DumberThanUsual/EEE3-Instrumentation/stupid drawing.jpg

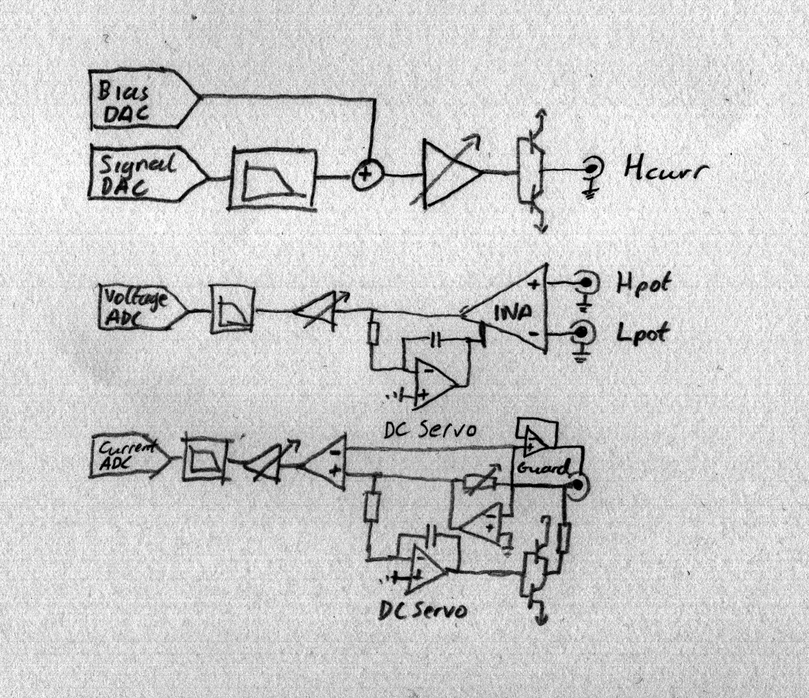
stupid drawing.jpg
