DumberThanUsual/EEE3-Instrumentation/Matlab App/Circuit Symbols/capacitor.png

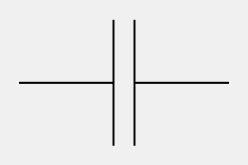
Matlab App/Circuit Symbols/capacitor.png
