DumberThanUsual/EEE3-Instrumentation/Matlab App/Circuit Symbols/impedance.png

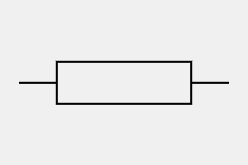
Matlab App/Circuit Symbols/impedance.png
