DumberThanUsual/EEE3-Instrumentation/Matlab App/Circuit Symbols/inductor.png

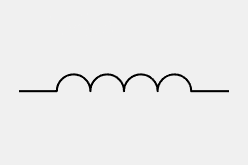
Matlab App/Circuit Symbols/inductor.png
