DumberThanUsual/EEE3-Instrumentation/Matlab App/Circuit Symbols/open.png

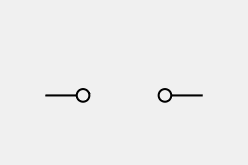
Matlab App/Circuit Symbols/open.png
