DumberThanUsual/EEE3-Instrumentation/Matlab App/Circuit Symbols/Other/base.png

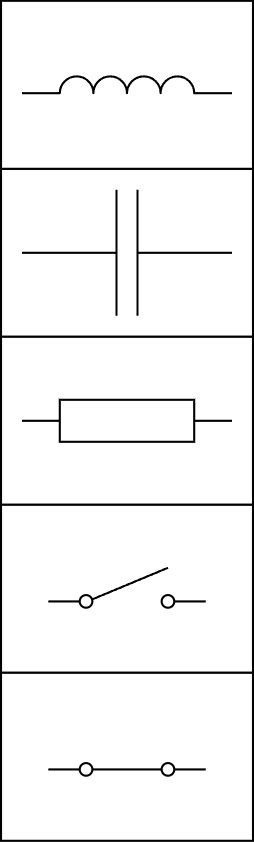
Matlab App/Circuit Symbols/Other/base.png
