DumberThanUsual/EEE3-Instrumentation/Report/Matlabs/sampleerrorvR.png

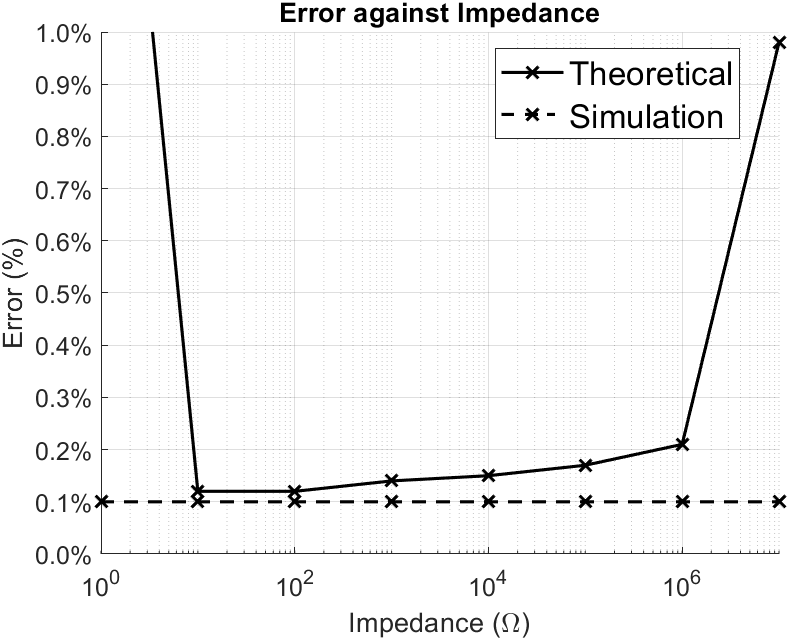
Report/Matlabs/sampleerrorvR.png
