DumberThanUsual/EEE3-Instrumentation/Report/Scopes/SIGLENT/SDS824X_HD_PNG_1.png

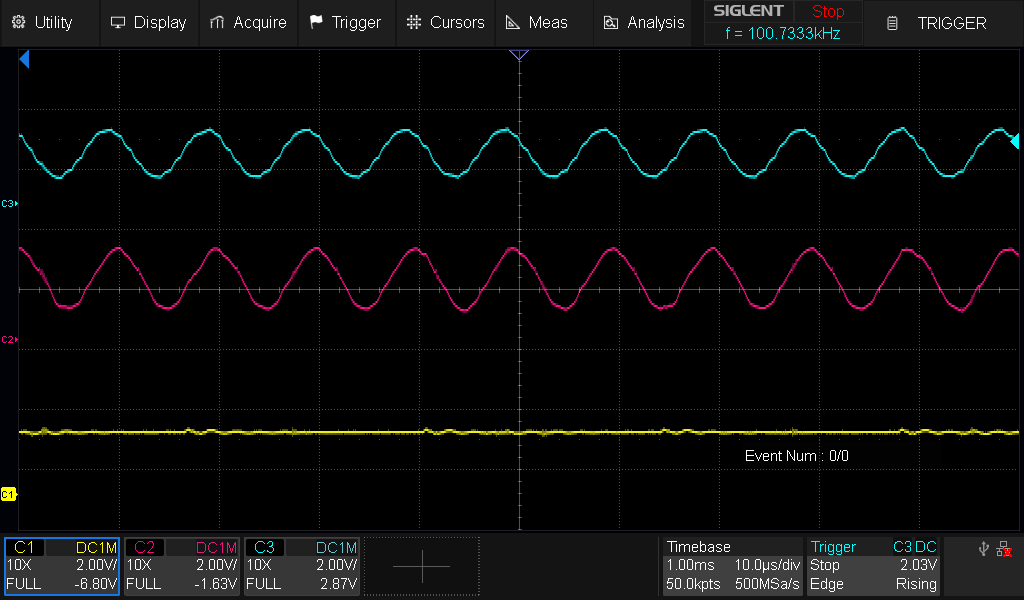
Report/Scopes/SIGLENT/SDS824X_HD_PNG_1.png
