DumberThanUsual/EEE3-Instrumentation/Report/Scopes/SIGLENT/SDS824X_HD_PNG_3.png

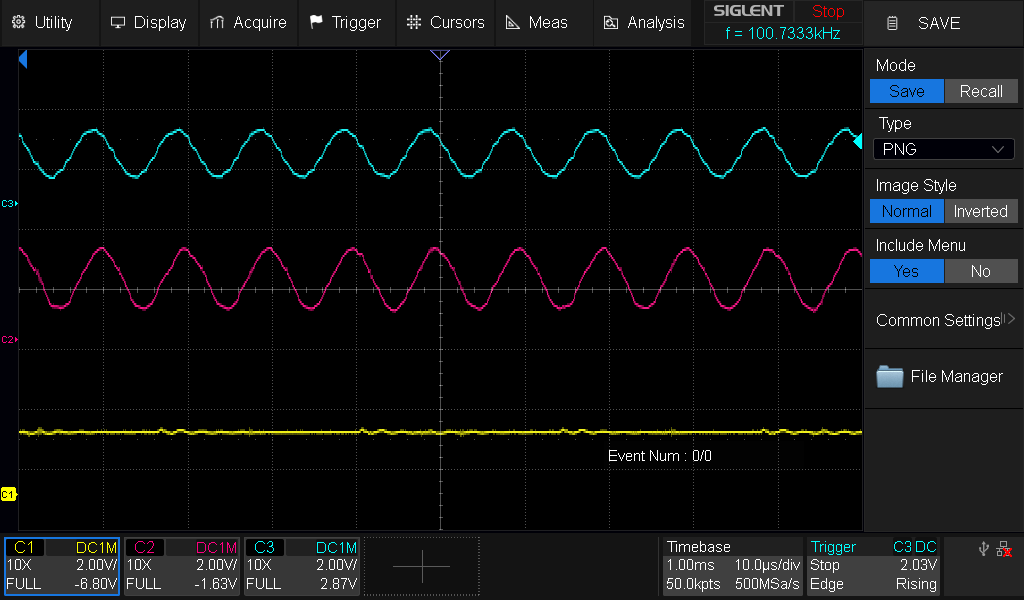
Report/Scopes/SIGLENT/SDS824X_HD_PNG_3.png
