DumberThanUsual/EEE3-Instrumentation/Report/Scopes/SIGLENT/SDS824X_HD_PNG_15.png

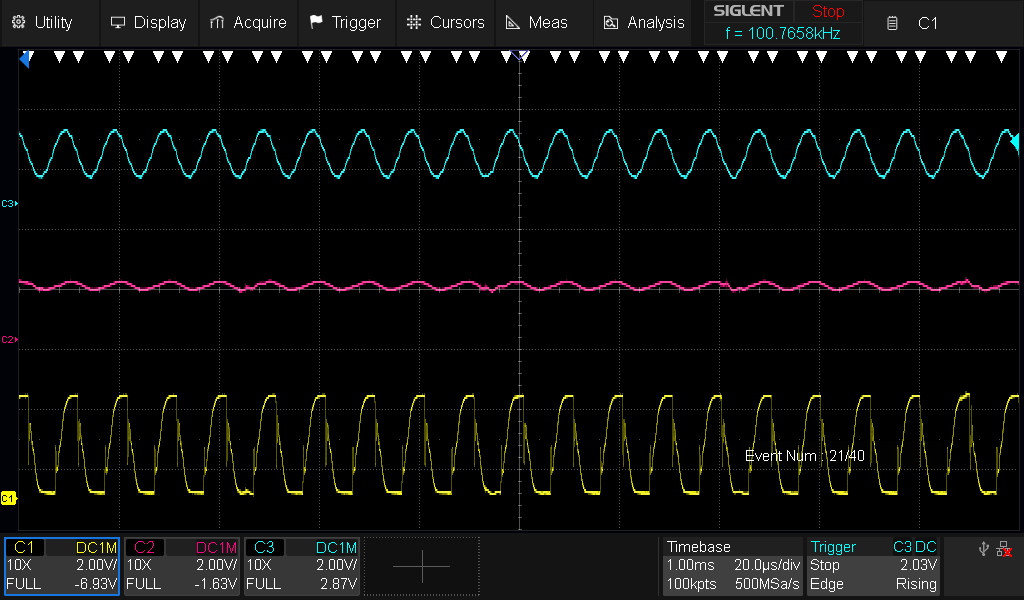
Report/Scopes/SIGLENT/SDS824X_HD_PNG_15.png
