DumberThanUsual/EEE3-Instrumentation/Report/Scopes/SIGLENT/SDS824X_HD_PNG_28.png

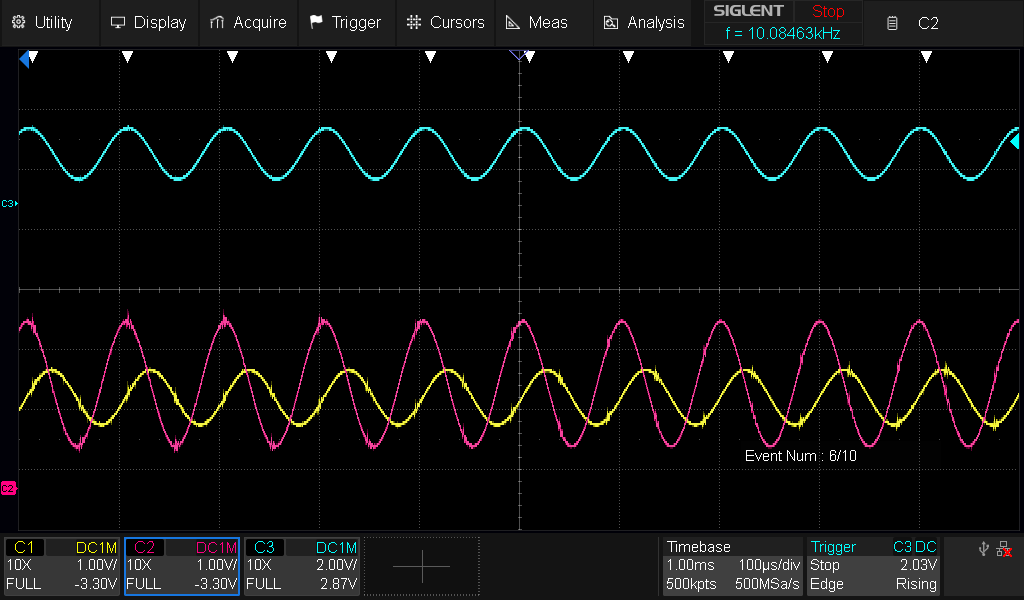
Report/Scopes/SIGLENT/SDS824X_HD_PNG_28.png
