DumberThanUsual/EEE3-Instrumentation/Report/Scopes/SIGLENT/using/SDS824X_HD_PNG_20.png

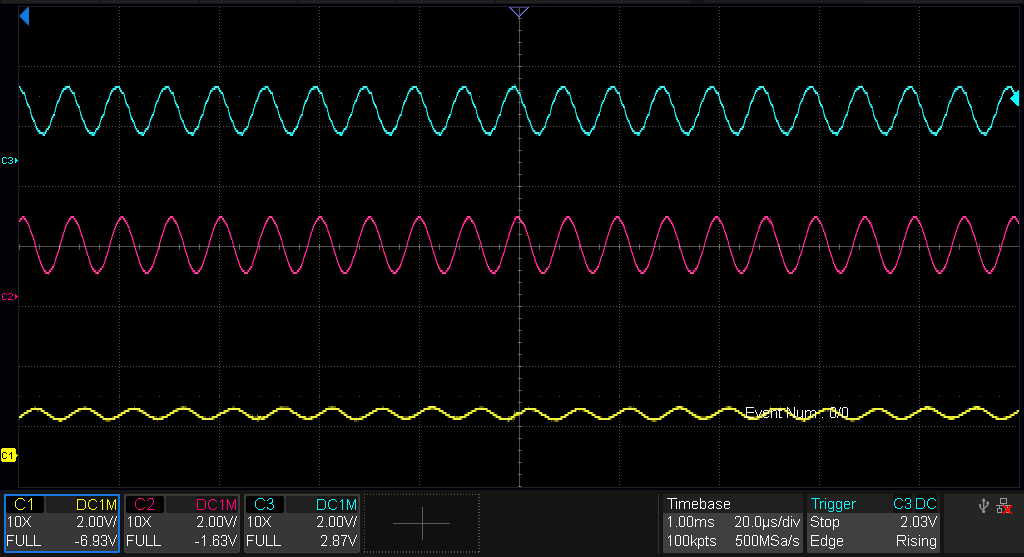
Report/Scopes/SIGLENT/using/SDS824X_HD_PNG_20.png
