DumberThanUsual/EEE3-Instrumentation/Simulations/2.2u.png

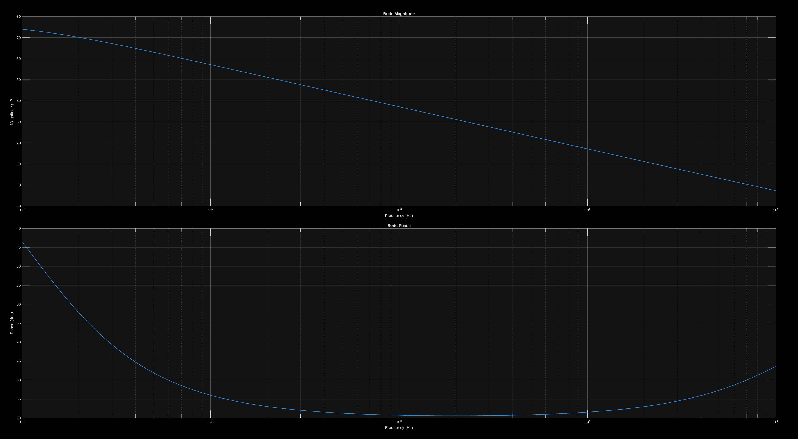
Simulations/2.2u.png
