DumberThanUsual/EEE3-Instrumentation/Simulations/Pasted image.png

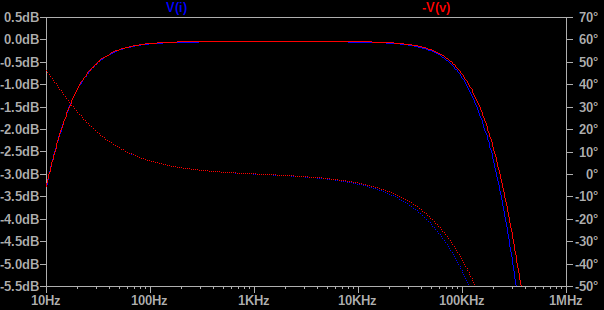
Simulations/Pasted image.png
