DumberThanUsual/EEE3-Instrumentation/Simulations/untitled.png

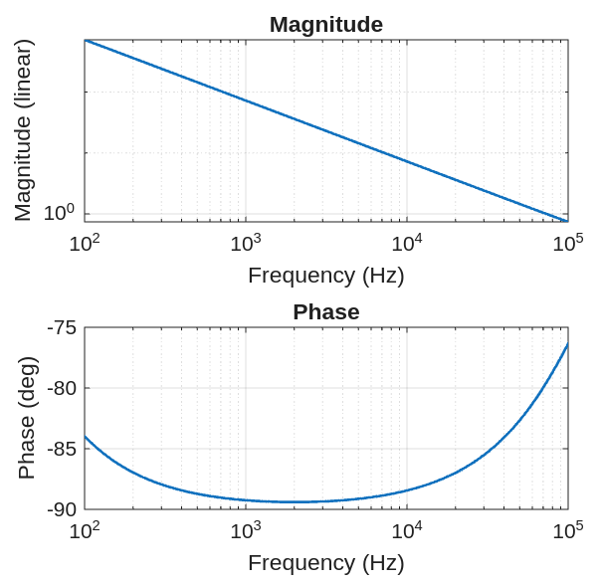
Simulations/untitled.png
