DumberThanUsual/EEE3-Instrumentation/uidiagram.bmp

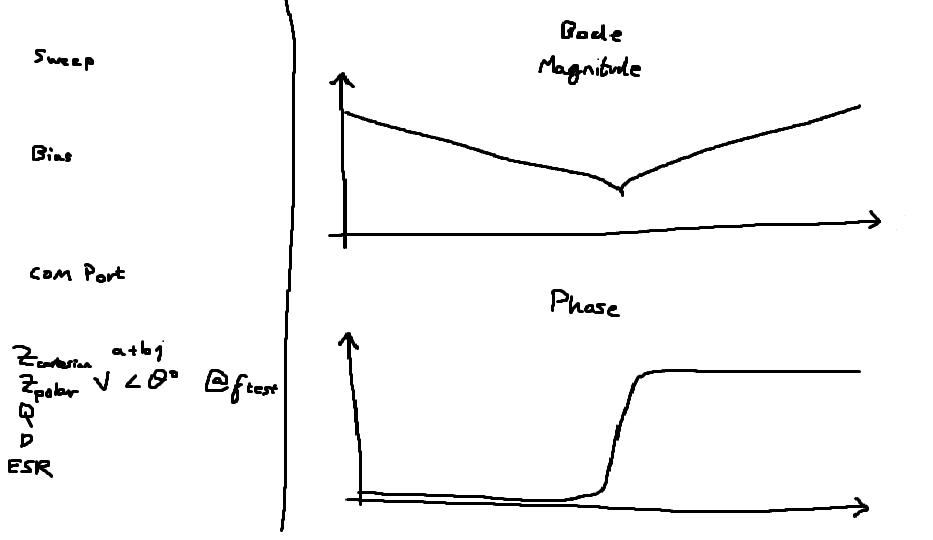
uidiagram.bmp
