DumberThanUsual/EEE3-Instrumentation/PCB/Main Board/Symbols/New folder/4816P-R2R-103LF/3D/4816P-R2R-103LF.stp

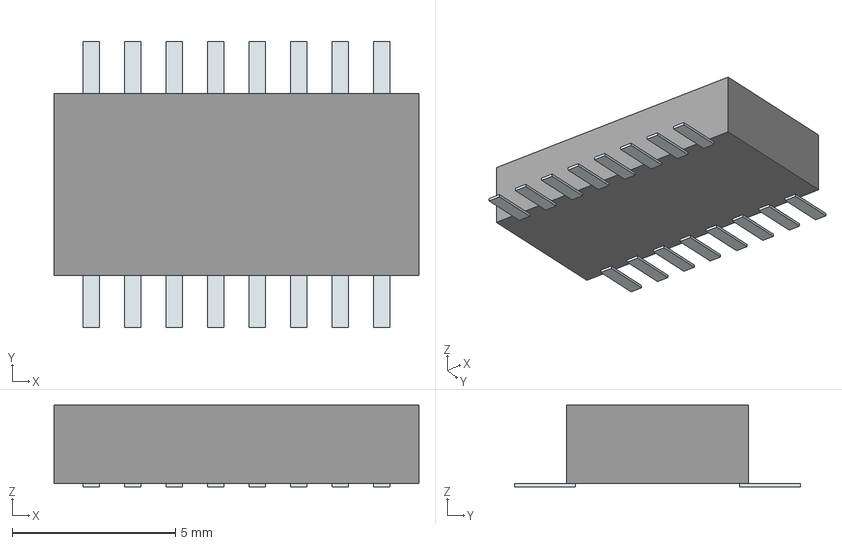
[picture p43: CAD file, 2026-03-01]
PCB/Main Board/Symbols/New folder/4816P-R2R-103LF/3D/4816P-R2R-103LF.stp
11.2 x 8.77 x 2.50 mm
Pins
