DumberThanUsual/EEE3-Instrumentation/(list of files, cad)

Other CAD files:
PCB/Main Board/Symbols/New folder/4816P-R2R-103LF/DEHDL/4816p_r2r_103lf/chips/chips.prt
