DumberThanUsual/EEE3-Instrumentation/PCB/Schematics/Main Board.pdf

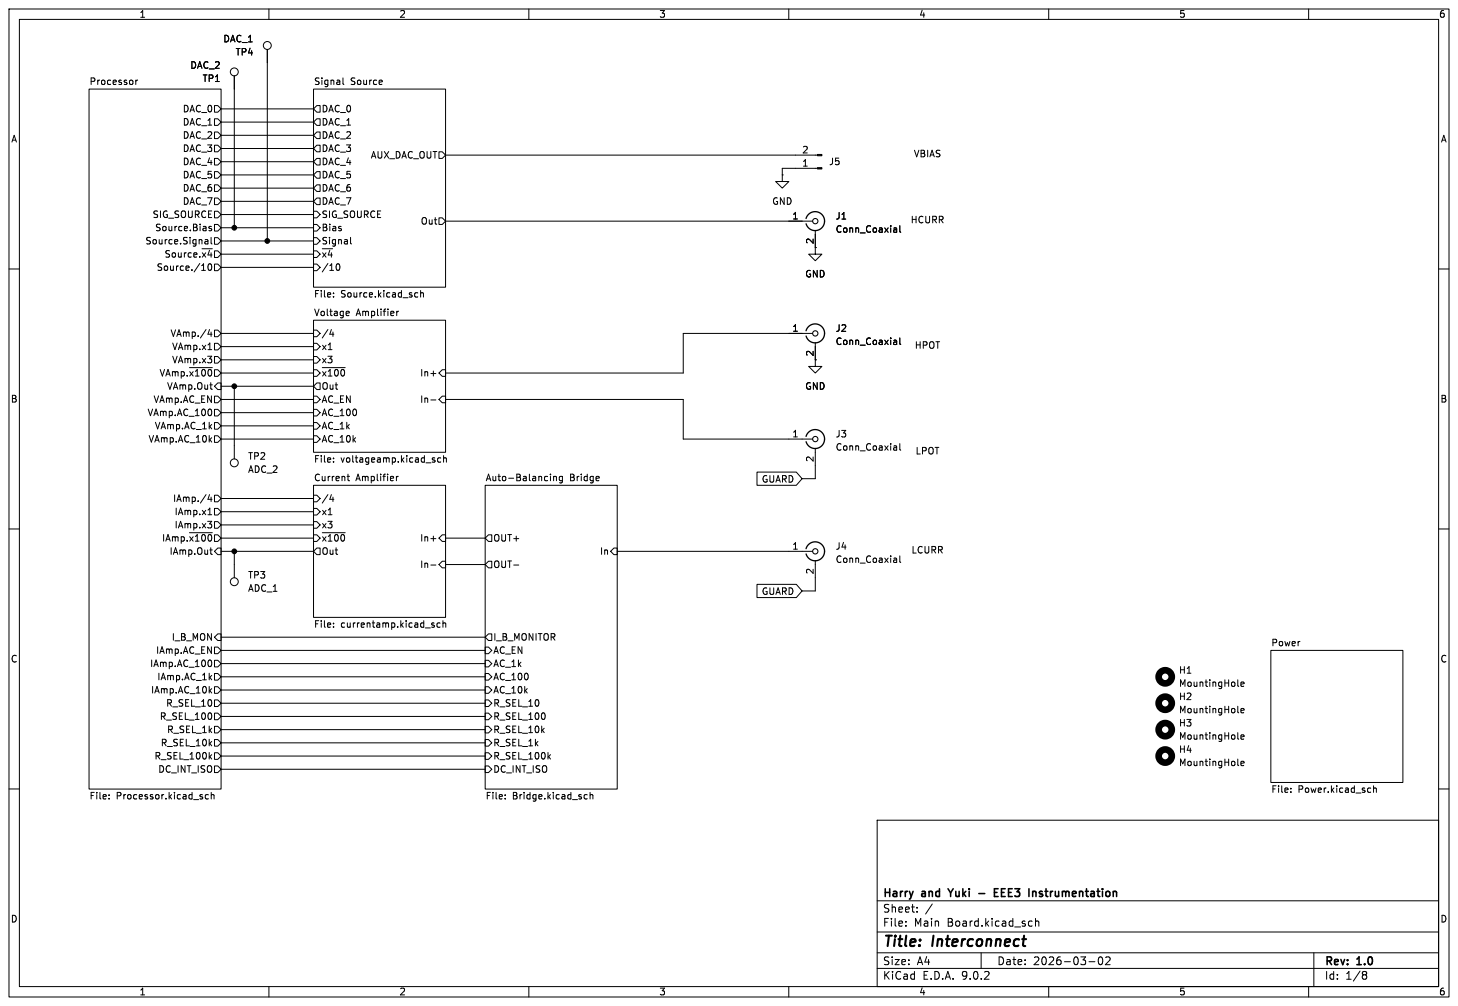
[picture p44: page 1]

IAmp.~{x100} Source.Bias Source.Signal Source./10 Source.~{x4} SIG_SOURCE R_SEL_1k R_SEL_10k R_SEL_10 R_SEL_100 DC_INT_ISO

/4 Voltage Amplifier File: voltageamp.kicad_sch

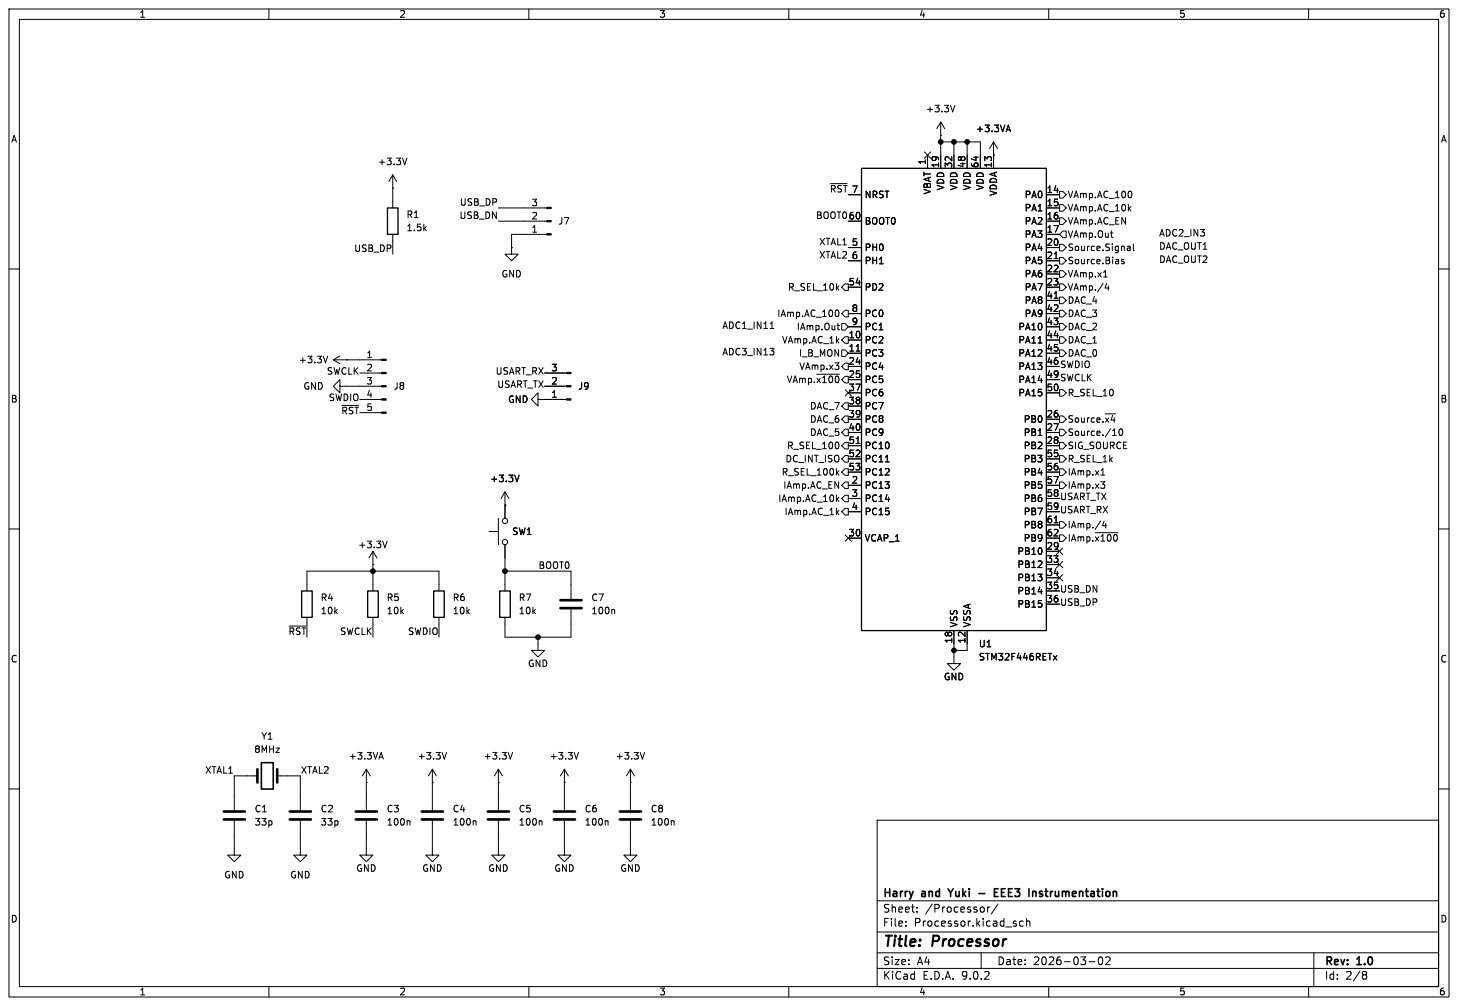
[picture p45: page 2]

VAmp.AC_100
VAmp.AC_10k
Source.Signal Source.Bias VAmp.AC_EN
VAmp.Out
IAmp.x3 DAC_3 VAmp.x1
VAmp./4 DAC_0 R_SEL_10 Source.~{x4} Source./10

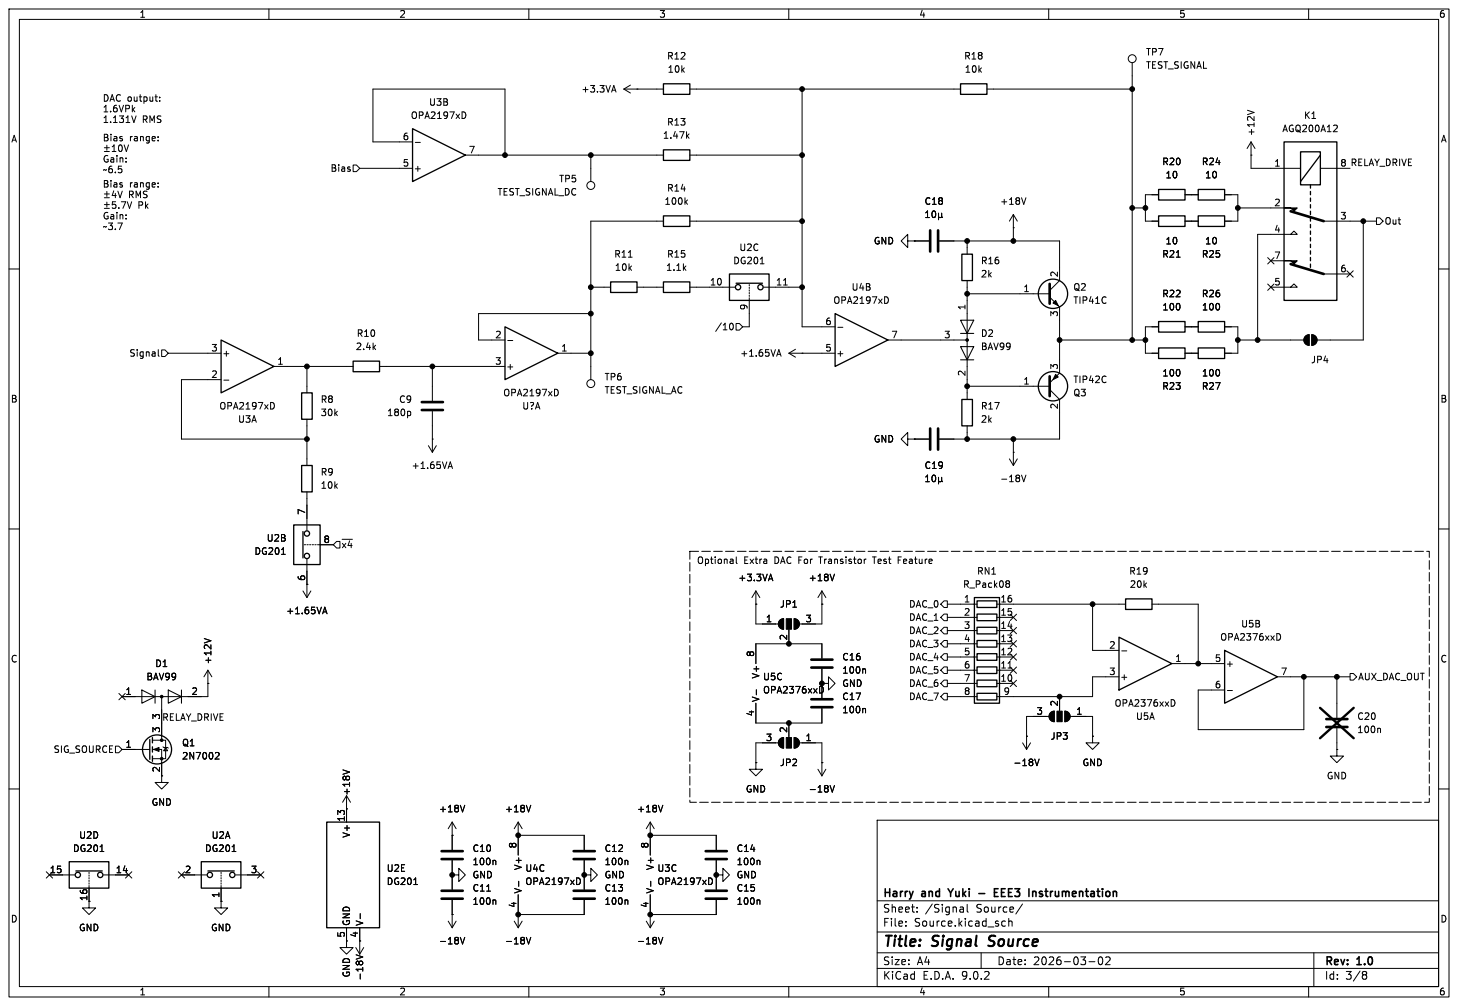
[picture p46: page 3]

Bias range: þÿ±4VRMS

Id: 3/8 Title: Signal Source

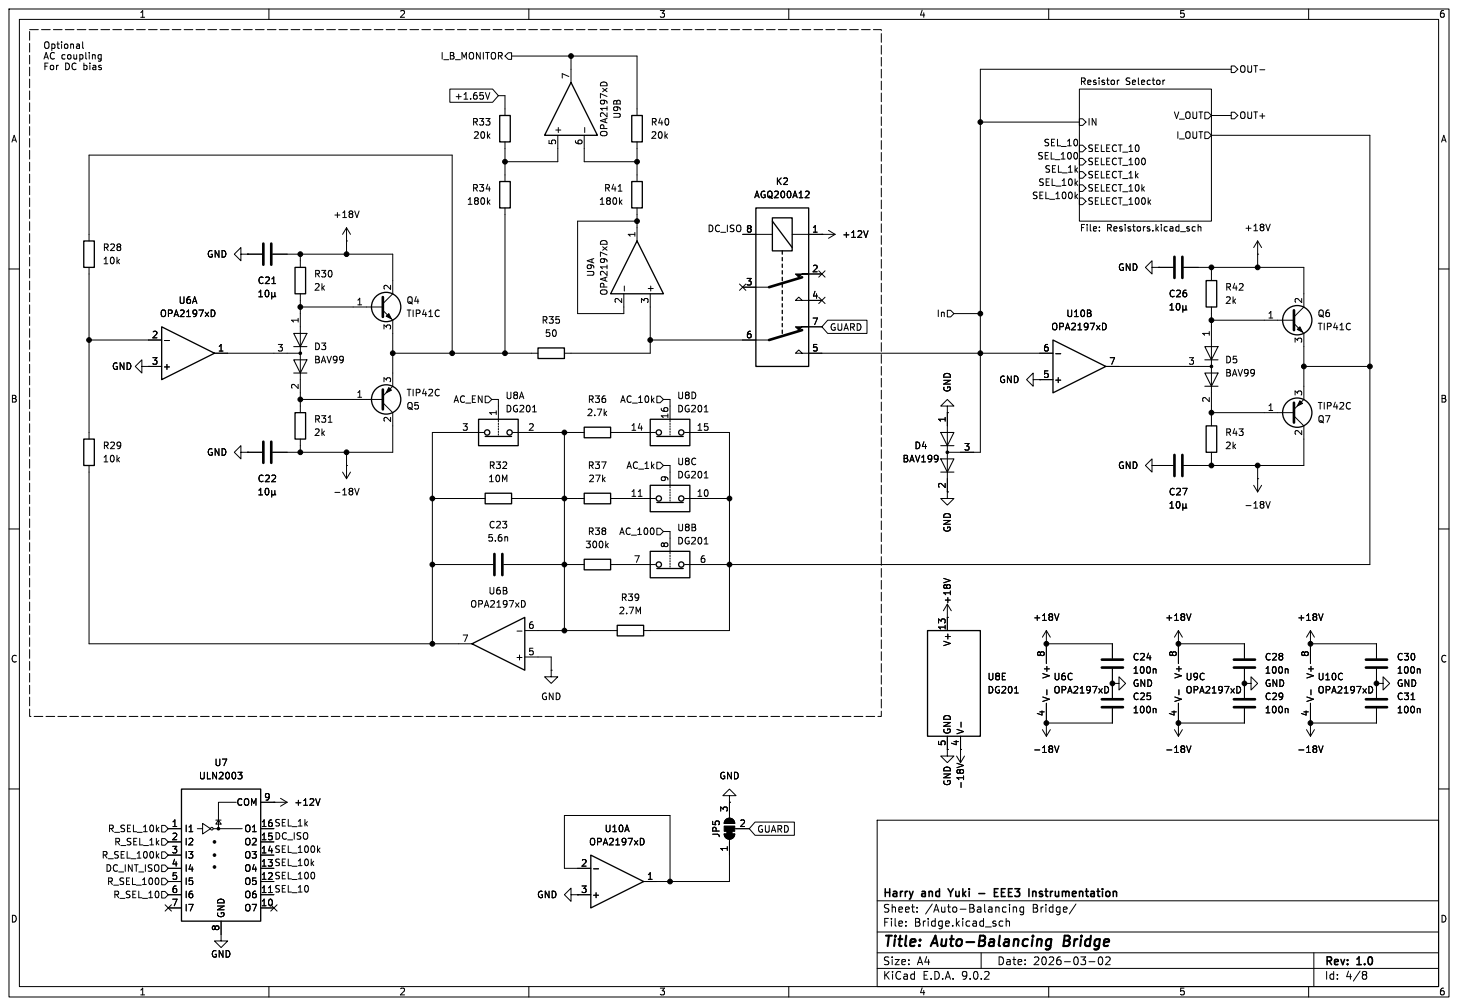
[picture p47: page 4]

7 U9B OPA2197xD R33
SELECT_1k Resistor Selector File: Resistors.kicad_sch R32

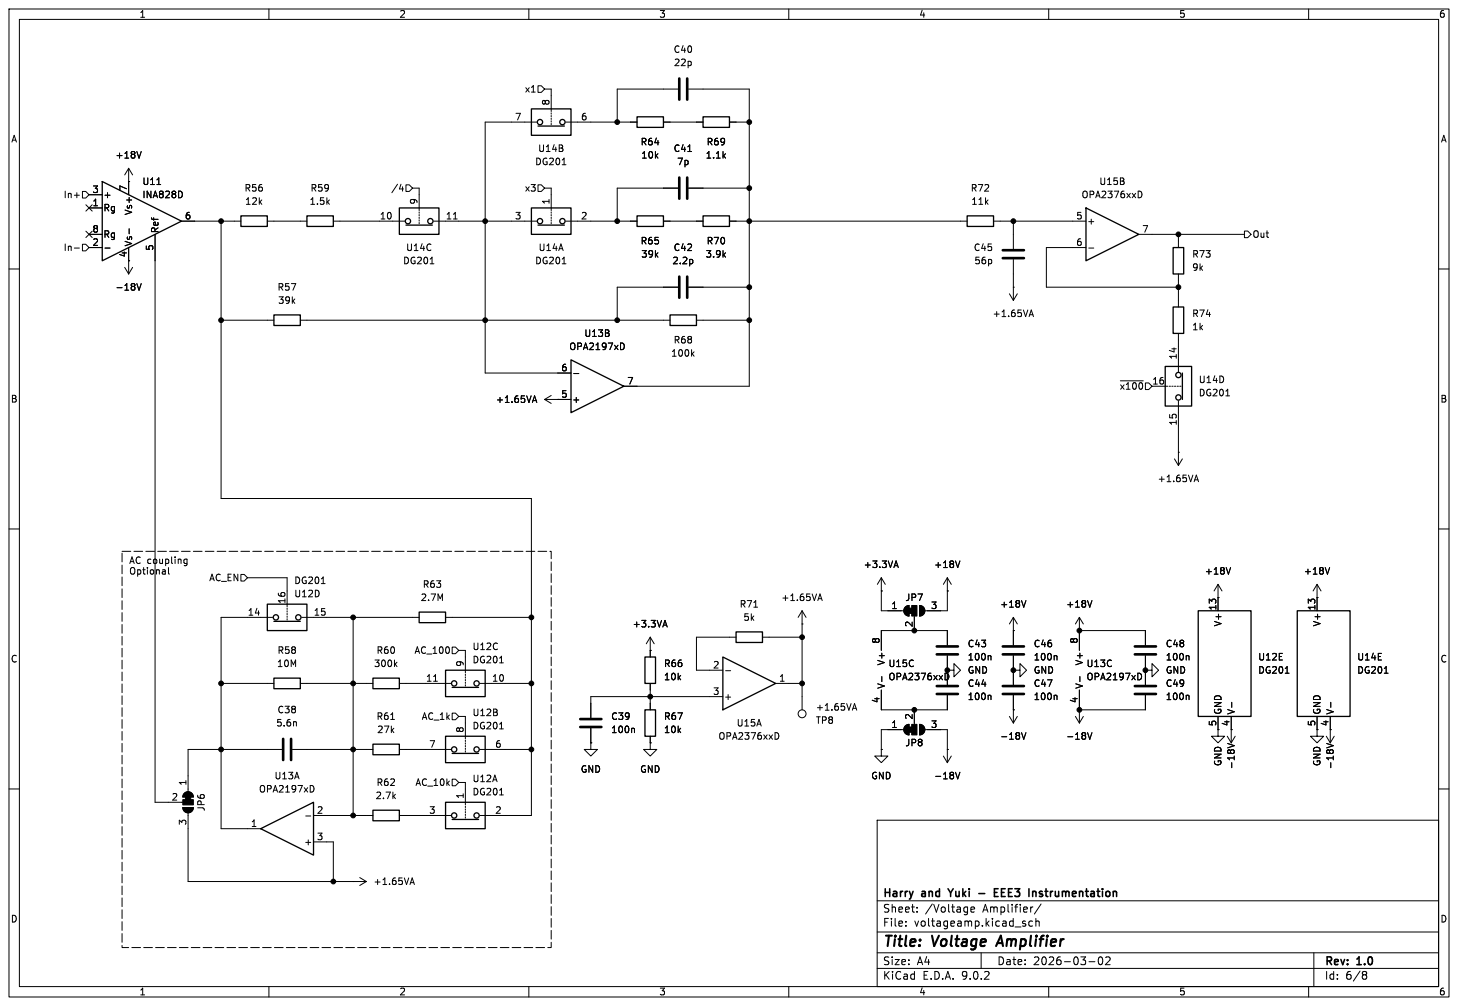
[picture p48: page 5]

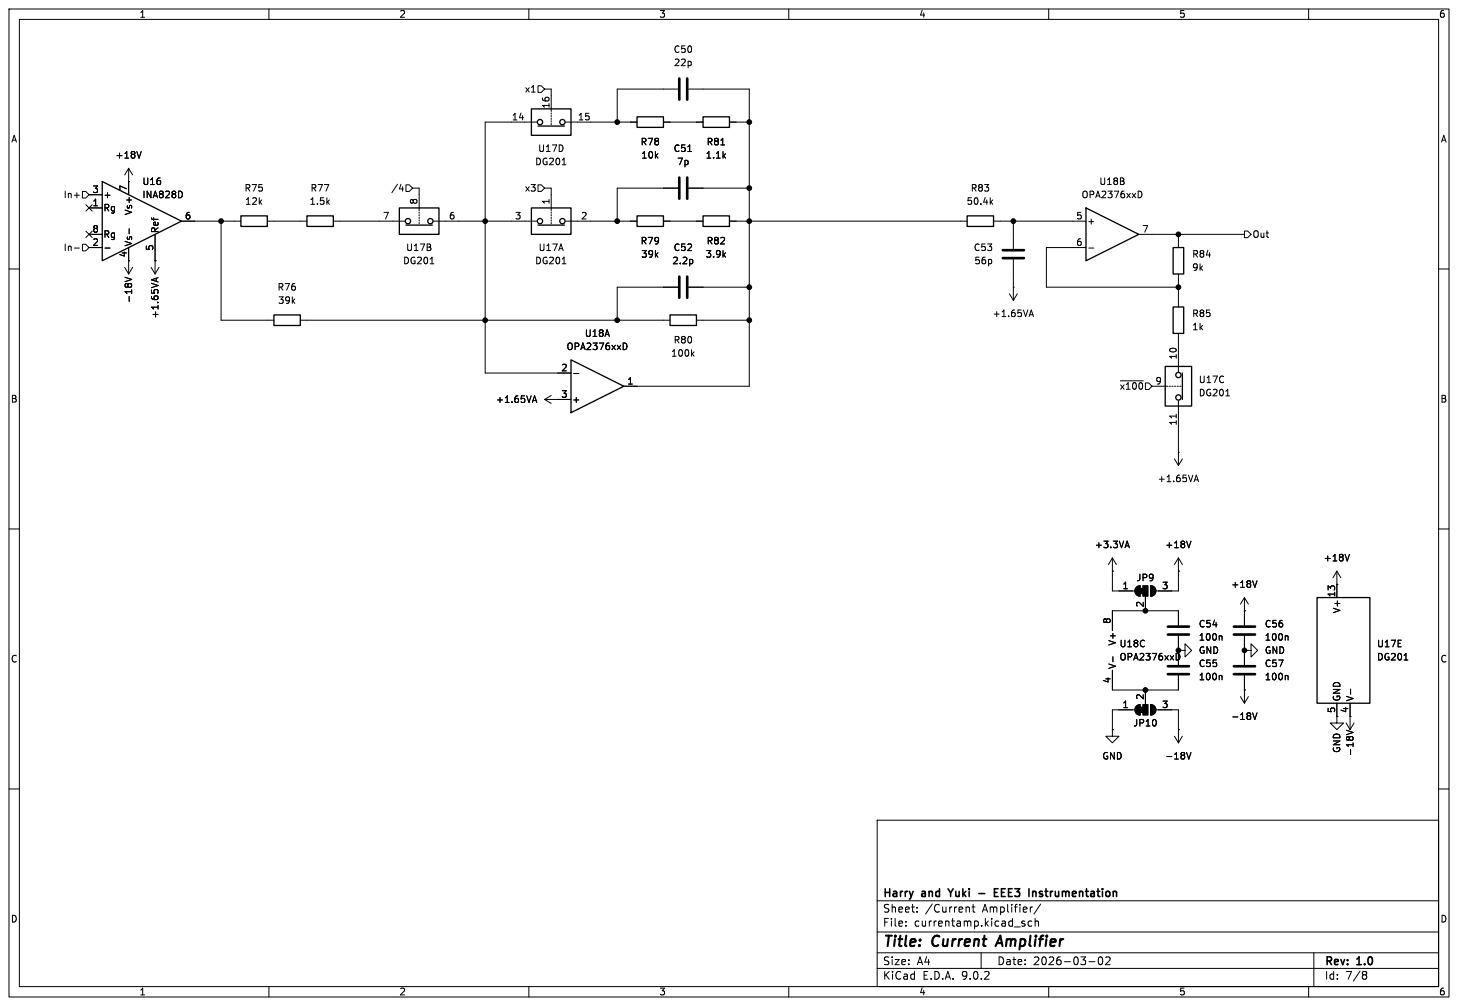
[picture p49: page 6]

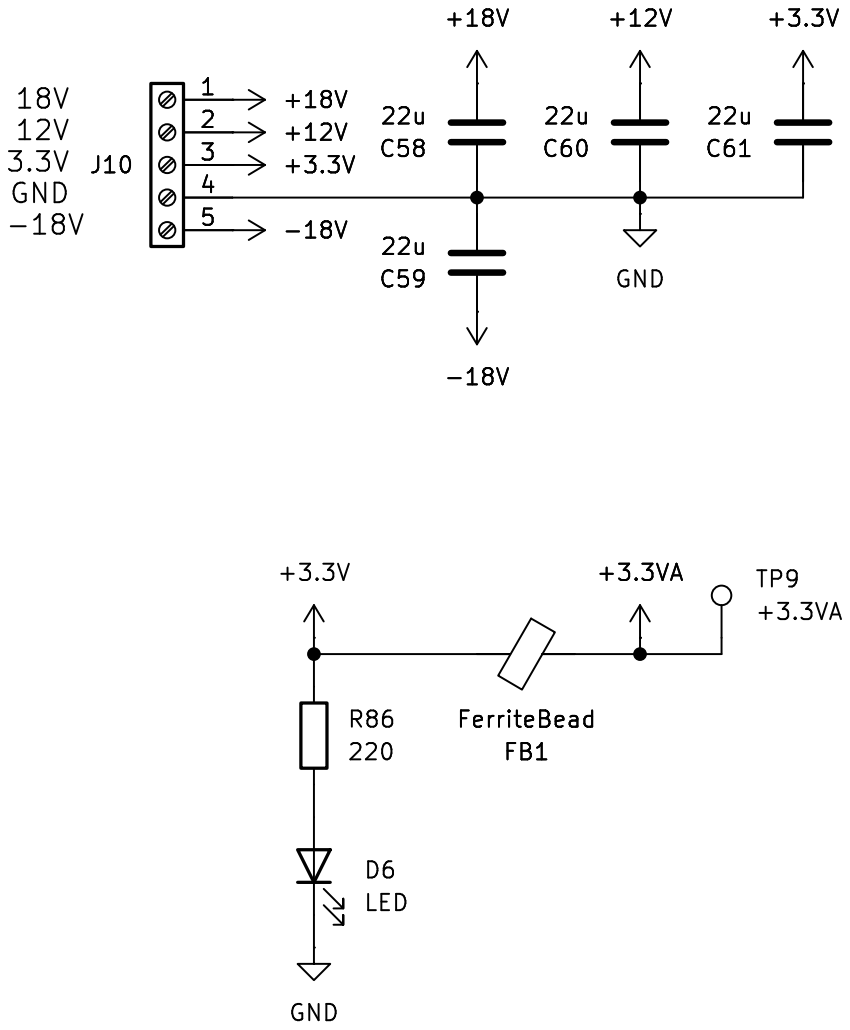
[picture p50: page 7]

Id: 8/8 Title: Power Supply

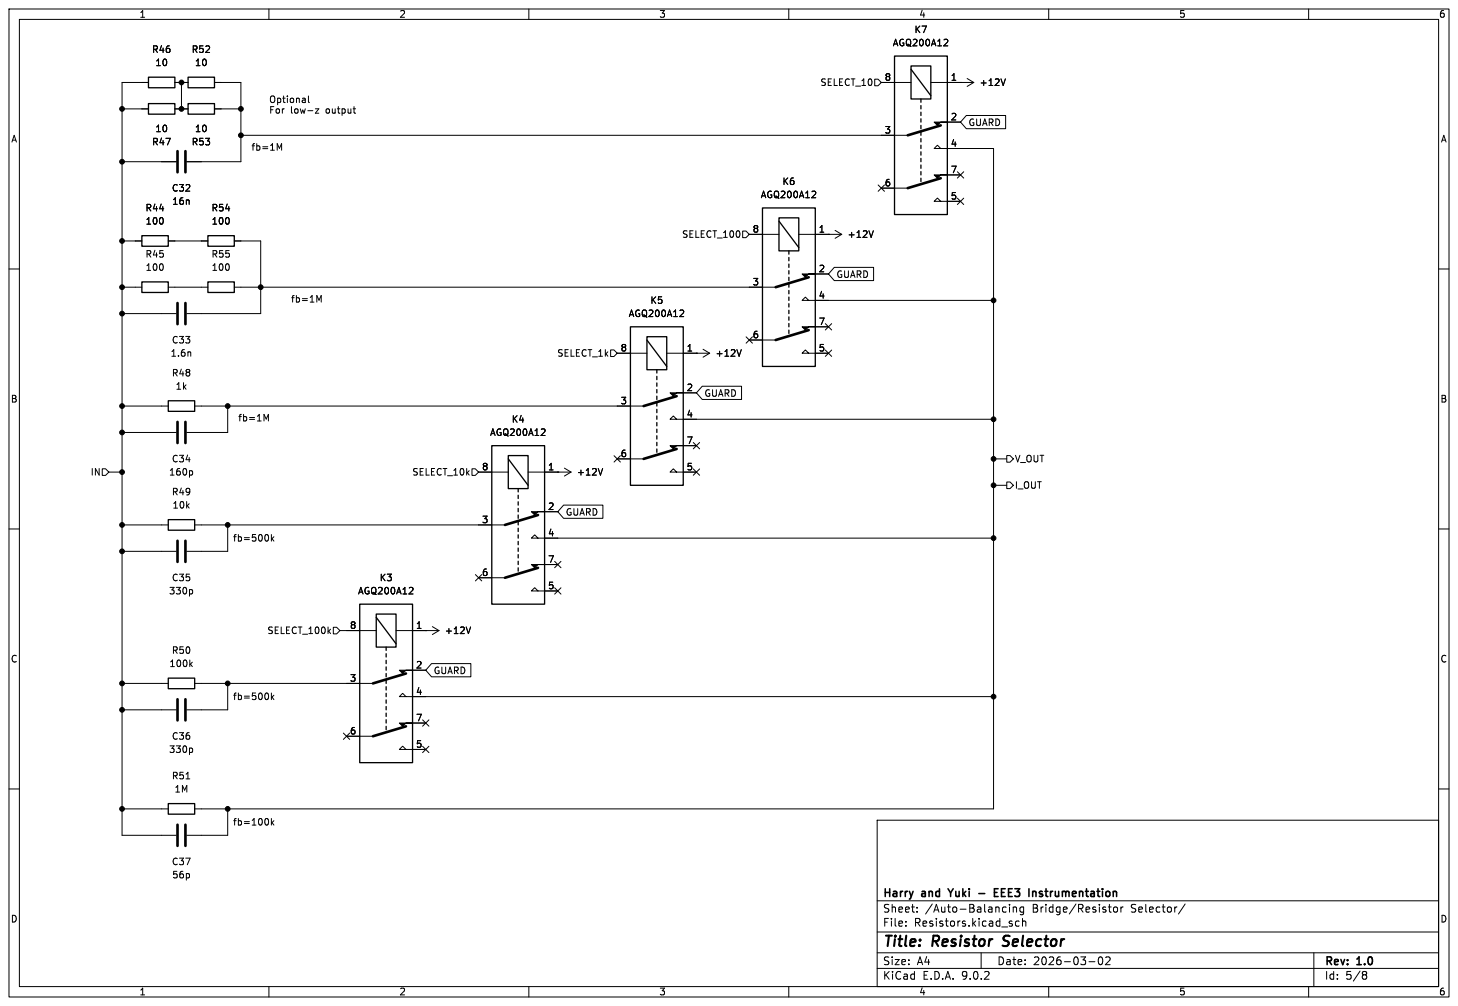
[picture p51: page 8]
