DumberThanUsual/EEE3-Instrumentation/PCB/Schematics/Metal Layers.pdf

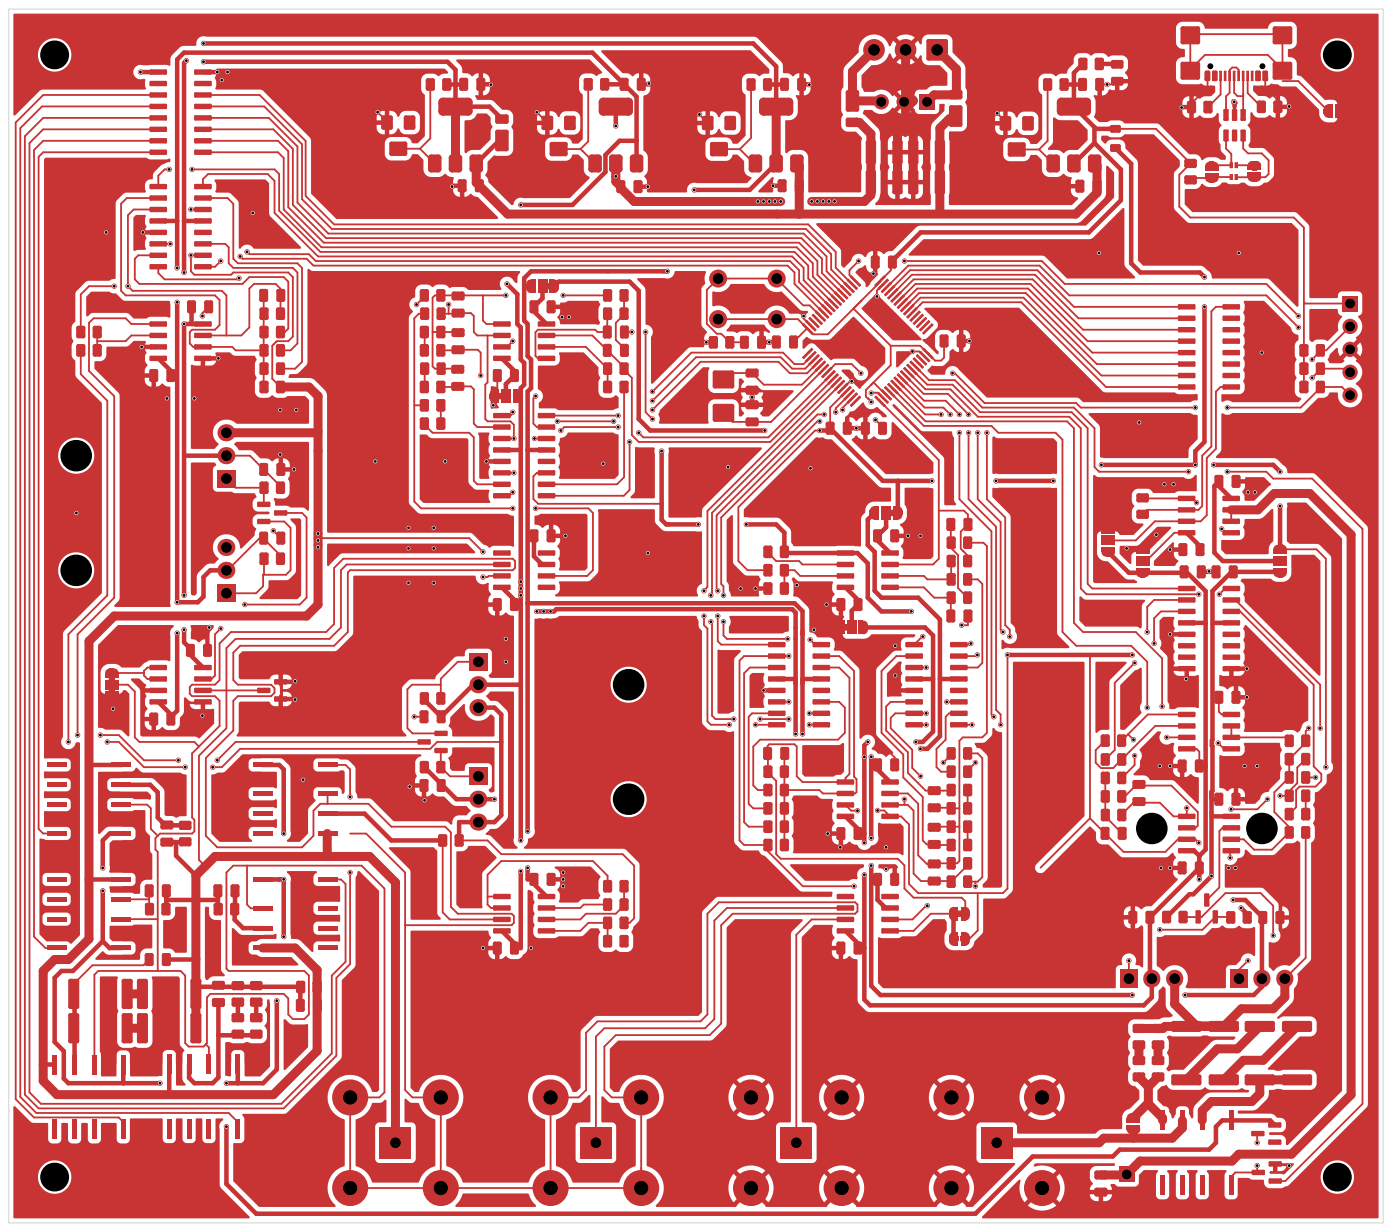
[picture p52: page 1]

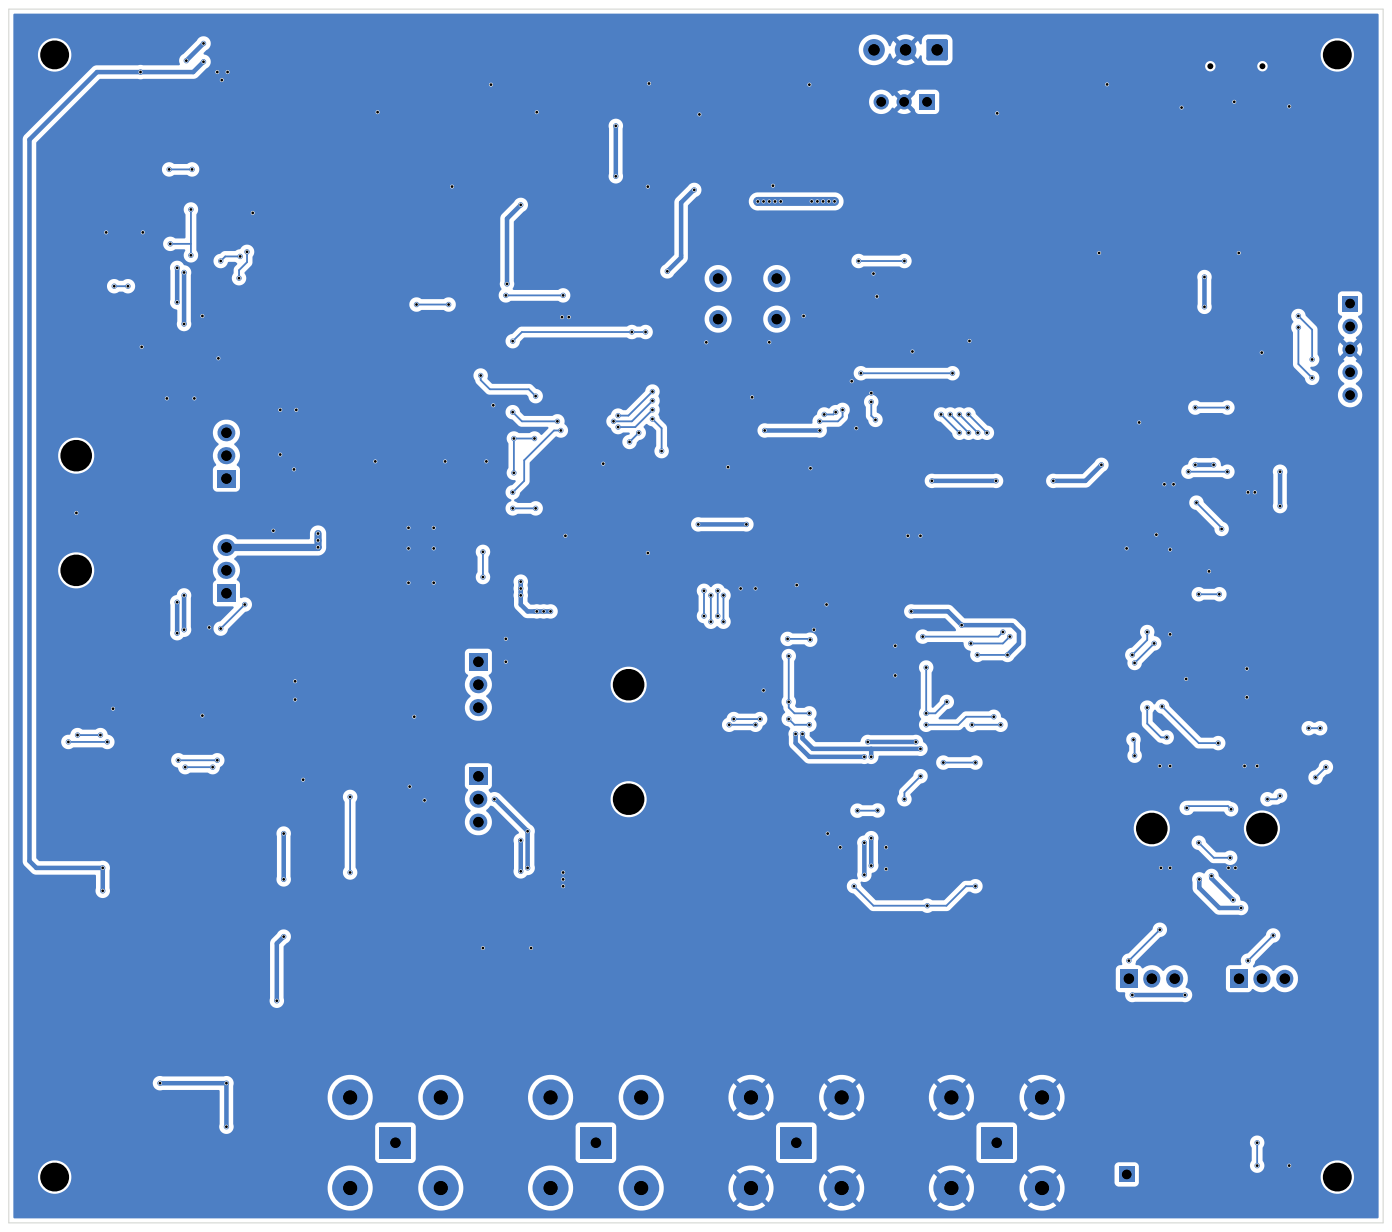
[picture p53: page 2]
