DumberThanUsual/EEE3-Instrumentation/Simulations/fr this time/Characterise.asc

R1: res; 1k
V1: voltage; 18
V2: voltage; 18
V3: voltage; 3.3
V4: voltage; SINE(0 1 10k); AC 1
X1: Vamp
X3: Iamp
Named nets: 0, +18V, -18V, 3.3V, V, I
.tran 1m
.ac dec 250 10 1Meg
