DumberThanUsual/EEE3-Instrumentation/Simulations/Complete.asc

C1: cap; 180p
C2: cap; 5.6n
C3: cap; 2.2p
C4: cap; 7p
C5: cap; 22p
C6: cap; 56p
C12: cap; 2.2p
C13: cap; 7p
C14: cap; 22p
C15: cap; 56p
Q1: npn
Q2: pnp
Q3: npn
Q4: pnp
R1: res; 10k
R2: res; 10k
R3: res; 30k
R4: res; 10k
R5: res; 2.4k
R6: res; 11.1k
R7: res; 100k
R8: res; 1.47k
R9: res; 10k
R10: res; 2k
R11: res; 2k
R12: res; 10k
R13: res; 100
R14: res; 2700k
R15: res; 300k
R16: res; 27k
R17: res; 2.7k
R18: res; 39k
R19: res; 100k
R20: res; 42.9k
R21: res; 13.5k
R22: res; 11.1k
R23: res; 11k
R24: res; 1k
R25: res; 9k
R26: res; 2k
R27: res; 2k
R28: res; 1Meg
R29: res; 100k
R30: res; 10k
R31: res; 1k
R32: res; 100
R33: res; 1k
R38: res; 39k
R39: res; 100k
R40: res; 13.5k
R41: res; 42.9k
R42: res; 11.1k
R43: res; 11k
R44: res; 1k
R45: res; 9k
U1: OPAx197
U2: OPAx197
U3: OPAx197
U4: OPAx197
U5: OPAx197
U6: OPAx197
U7: BAV99
U8: BAV99
U9: INA828
U10: OPAx197
U11: OPAx197
U12: OPAx197
U13: OPAx197
U14: BAV99
U15: BAV99
U16: INA828
U18: OPAx197
U19: OPAx197
V1: voltage; 18
V2: voltage; 18
V3: voltage; 3.3
V4: voltage; 1.65; AC 1
Named nets: 0, +18V, -18V, 3.3V, 1.65V, HCURR, HPOT, LPOT, Vout, LCURR, Iout
.tran 1m
.dc V4 0 3.3 0.01
.ac dec 10 1 10000k
