DumberThanUsual/EEE3-Instrumentation/Simulations/big.asc

C1: cap; 330p
C2: cap; 5.6n
C3: cap; 2.2p
C4: cap; 7p
C5: cap; 22p
C6: cap; 56p
C7: cap; 2.2p
C8: cap; 7p
C9: cap; 22p
C10: cap; 56p
R1: res; 10k
R2: res; 10k
R3: res; 1k
R4: res; 39k
R5: res; 100k
R6: res; 13.5k
R7: res; 42.9k
R8: res; 11.1k
R9: res; 11k
R10: res; 1k
R11: res; 9k
R12: res; 1k
R14: res; 2700k
R15: res; 300k
R16: res; 27k
R17: res; 2.7k
R18: res; 39k
R19: res; 100k
R20: res; 42.9k
R21: res; 13.5k
R22: res; 11.1k
R23: res; 11k
R24: res; 1k
R25: res; 9k
U1: OPAx197
U2: OPAx197
U3: OPAx197
U4: OPAx197
U5: OPAx197
U6: INA828
U9: INA828
U10: OPAx197
U11: OPAx197
U12: OPAx197
V1: voltage; 18
V2: voltage; 18
V3: voltage; 3.3
V4: voltage; ""; AC 1
Named nets: 0, +18V, -18V, 3.3V, 1.65V, Vout, Iout
.tran 1m
.dc V4 0 3.3 0.01
.ac dec 10 10 1000k
