DumberThanUsual/EEE3-Instrumentation/Simulations/whole.asc

C1: cap; 330p
C7: cap; 5.6n
I1: current; ""; AC 1m
Q3: npn
Q4: pnp
Q5: npn
Q6: pnp
R1: res; 10k
R2: res; 10k
R26: res; 2k
R27: res; 2k
R28: res; 1Meg
R29: res; 100k
R30: res; 10k
R31: res; 1k
R32: res; 100
R34: res; 2700k
R35: res; 300k
R36: res; 27k
R37: res; 2.7k
R46: res; 2k
R47: res; 2k
R48: res; 10k
R49: res; 10k
U2: OPAx197
U13: OPAx197
U14: BAV99
U15: BAV99
U17: OPAx197
U20: OPAx197
U21: BAV99
U22: BAV99
V1: voltage; 18
V2: voltage; 18
V3: voltage; 3.3
Named nets: 0, +18V, -18V, 3.3V, 1.65V, LCURR
.tran 1m
.dc V4 0 3.3 0.01
.ac dec 10 1 10000k
