DumberThanUsual/EEE3-Instrumentation/Simulations/fr this time/Iamp.asc

C1: cap; 0.3p
C2: cap; 5.6n
C3: cap; 2.2p
C4: cap; 7p
C5: cap; 22p
C6: cap; 56p
C7: cap; 3p
C8: cap; 30p
C9: cap; 30p
C10: cap; 3n
Q1: npn
Q2: npn
R1: res; 10k
R2: res; 10k
R3: res; 1Meg
R4: res; 111k
R5: res; 10k
R6: res; 1k
R7: res; 100
R8: res; 10k
R9: res; 10k
R10: res; 10k
R11: res; 10k
R12: res; 10k
R13: res; 10k
R14: res; 2700k
R15: res; 300k
R16: res; 27k
R17: res; 2.7k
R18: res; 39k
R19: res; 100k
R20: res; 42.9k
R21: res; 13.5k
R22: res; 11.1k
R23: res; 11k
R24: res; 1k
R25: res; 9k
R26: res; 10k
R27: res; 10k
R32: res; 10k
R33: res; 10k
R34: res; 10k
R35: res; 10k
S1: sw
S2: sw
S3: sw
S4: sw
S5: sw
S6: sw
S7: sw
S8: sw
U1: OPAx197
U2: OPAx197
U3: OPAx197
U9: INA828
U11: OPAx197
U12: OPAx197
V1: voltage; 18
V2: voltage; 18
V3: voltage; 3.3
Named nets: 0, +18V, -18V, 3.3V, 1.65V, LCURR, V_MEAS, x100, x3, /4, 100k, 10k, 1k, 100, x10
.tran 1m
.ac dec 10 1 10000k
.model SW SW(Ron=0.01, Roff=10G, Vt=1.65)
