DumberThanUsual/EEE3-Instrumentation/Simulations/fr this time/Vamp.asc

C2: cap; 5.6n
C3: cap; 1p
C4: cap; 5p
C5: cap; 14p
C6: cap; 56p
Q1: npn
Q2: npn
R1: res; 10k
R2: res; 10k
R3: res; 10k
R4: res; 10k
R5: res; 10k
R6: res; 10k
R7: res; 10k
R8: res; 10k
R14: res; 2700k
R15: res; 300k
R16: res; 27k
R17: res; 2.7k
R18: res; 39k
R19: res; 100k
R20: res; 42.9k
R21: res; 13.5k
R22: res; 11.1k
R23: res; 11k
R24: res; 1k
R25: res; 9k
S1: sw
S2: sw
S3: sw
S4: sw
U2: OPAx197
U9: INA828
U10: OPAx197
U11: OPAx197
U12: OPAx197
V1: voltage; 18
V2: voltage; 18
V3: voltage; 3.3
Named nets: 0, +18V, -18V, 3.3V, 1.65V, HPOT, LPOT, V_MEAS, x100, x3, x10, /4
.tran 1m
.dc V4 0 3.3 0.01
.ac dec 10 1 10000k
.model SW SW(Ron=0.01, Roff=10G, Vt=1.65)
