DumberThanUsual/EEE3-Instrumentation/Simulations/Partial Sim/partial.asc

C3: cap; 2.2p
C6: cap; 56p
C12: cap; 2.2p
C15: cap; 56p
R1: res; 1k
R2: res; 10k
R18: res; 39k
R19: res; 100k
R23: res; 11k
R24: res; 1k
R25: res; 9k
R38: res; 39k
R39: res; 100k
R43: res; 11k
R44: res; 1k
R45: res; 9k
U9: INA828
U11: OPAx197
U12: OPAx197
U13: OPAx197
U16: INA828
U18: OPAx197
U19: OPAx197
V1: voltage; 18
V2: voltage; 18
V3: voltage; 3.3
V4: voltage; SINE(1.65 1.65); AC 1
V5: voltage; 1.65
Named nets: 0, +18V, -18V, 3.3V, HCURR, HPOT, LPOT, 1.65V, Vout, LCURR, Iout
.tran 1m
.dc V4 0 3.3 0.01
.ac dec 10 1 10000k
