DumberThanUsual/EEE3-Instrumentation/Simulations/Buffer/buffer.asc

C1: cap; 10n
C2: cap; 10n
D1: diode
D2: diode
Q1: pnp; 2N4403
Q2: npn; 2N4401
R3: res; 200
R4: res; 200
U1: opamp
V1: voltage; SINE(0 1 1Meg)
V2: voltage; 18
V3: voltage; 18
V4: voltage; PULSE(-18 18 1f 5u 1 1 1)
Named nets: V+, V-, 0
.tran 0 5u 0 1u
.model D D(Ron=1m Roff=10Meg Vfwd=0.75 Vrev=100)
.lib opamp.sub
