DumberThanUsual/EEE3-Instrumentation/Simulations/Mini Driver/driver.asc

L1: ind; 10µ
M1: nmos; 2N7002
R1: res; 1k
V1: voltage; PULSE(0 3.3 0 100n 100n 400n 1u)
V2: voltage; 12
Named nets: 0, V+
.tran 0 5u 0 1u
.model D D(Ron=1m Roff=10Meg Vfwd=0.75 Vrev=100)
.lib opamp.sub
