DumberThanUsual/EEE3-Instrumentation/Simulations/ABB/Draft1.asc

R1: res; 100
R2: res; {Rg}
U1: opamp; Aol={Aol}
V1: voltage; SINE(0); AC AC
Named nets: 0, Vout
DUT
.ac dec 50 10 1Meg
.step param Rg list 1k 100k 10Meg
.lib opamp.sub
.param gainbandwidth Aol*Pole
.step param Pole list 10 100
.step param Aol list 100k 1Meg
