DumberThanUsual/EEE3-Instrumentation/Simulations/TIA/Draft1.asc

C1: cap; 100n
R1: res; 100k
R2: res; 100k
R3: res; 10k
R4: res; 10k
R5: res; 10k
R6: res; 10k
R7: res; 100k
U1: opamp
U2: opamp
U3: opamp
V1: voltage; ""; AC 1
Named nets: 0
.ac dec 100 0.01 1Meg
.lib opamp.sub
