DumberThanUsual/EEE3-Instrumentation/Simulations/TIA/ctest.asc

C1: cap; 0.1p
C2: cap; 0.5p
C3: cap; 1p
C4: cap; 1p
C6: cap; 1p
C7: cap; 1p
C8: cap; 100p
R1: res; 10
R2: res; 1Meg
R3: res; 1Meg
R4: res; 10
R5: res; 1Meg
R6: res; 1Meg
R7: res; 10
R8: res; 1Meg
R9: res; 1Meg
R10: res; 1Meg
R11: res; 1Meg; tol=1 pwr=0.1
R12: res; 10
R13: res; 1Meg
R14: res; 1Meg
R15: res; 10
R16: res; 10k
R17: res; 10k
R18: res; 10
R19: res; 10k
R20: res; 10k
U1: MAX333A
U2: ADA4610
U3: AD8651
U4: AD8651
U5: ADG412
U6: ADA4610
U7: ADA4610
U8: AD8651
U9: MAX333A
U10: AD8651
U11: ADA4610
U12: ADA4610
U13: AD8651
U14: AD8651
U15: ADA4610
U16: AD8651
V1: voltage; 15
V2: voltage; 3.6
V3: voltage; 15
V4: voltage; 1.8
V5: voltage; SINE(1.8 0.1 10k); AC 1 0
V6: voltage; SINE(1.8 0.1 10k); AC 1 0
V7: voltage; SINE(1.8 0.1 10k); AC 1 0
V8: voltage; SINE(1.8 0.1 10k); AC 1 0
V9: voltage; SINE(1.8 0.1 10k); AC 1 0
V10: voltage; SINE(1.8 0.1 10k); AC 1 0
V11: voltage; SINE(1.8 0.1 10k); AC 1 0
Named nets: 0, +15V, -15V, +3.6V, +1.8V, Guard+, unswitched, Mux1, Sw1, Mux2, Relay1, Relay2, Relay3
.ac dec 100 10k 10Meg
.tran 5m
