DumberThanUsual/EEE3-Instrumentation/Simulations/TIA/switching.asc

C1: cap; 30f
C2: cap; 100f
C3: cap; 1p
C4: cap; 5p
C5: cap; 0.5p
C6: cap; 0.5p
C7: cap; 5p
C8: cap; 5p
R1: res; 1Meg
R2: res; 1Meg
R3: res; 1Meg
R4: res; 1Meg
R5: res; 100
R6: res; 10G
R7: res; 1
U1: AD8651
U2: AD8651
U3: AD8651
V1: voltage; 15
V2: voltage; 3.6
V3: voltage; 1.8
V4: voltage; 15
V5: voltage; ""; AC 1
V6: voltage; ""; AC 1
Named nets: +15, +3.6, +1.8, -15, 0, Outref, Out, Guard
.ac dec 100 10k 2Meg
