DumberThanUsual/EEE3-Instrumentation/Simulations/InAmpStage2/Draft1.asc

C1: cap; 2.2p
C2: cap; 27p
R1: res; 9.09k
R2: res; 11k
R3: res; 49.9k
R4: res; 5.5k
U1: ADG1412
U2: ADG1412
U4: ADA4610
V1: voltage; 15
V2: voltage; 3.6
V3: voltage; 15
V4: voltage; 1.8
V5: voltage; SINE(1.8 0.1 10k); AC 1 0
Named nets: 0, +15V, -15V, +3.6V, +1.8V
.ac dec 100 0.1 100k
.tran 5m
