DumberThanUsual/EEE3-Instrumentation/Simulations/Buffer/More Complicated Buffer/buffer.asc

C1: cap; 1µ
D3: diode; 1N4148
I3: current; PULSE(0 100m 0 5u 1 1 1 1)
M1: nmos; IRF530
M2: pmos; IRF7343P
M3: nmos; IRF530
R1: res; 100
R2: res; 1k
R5: res; 1k
U1: opamp
V1: voltage; SINE(0 1 1Meg)
V2: voltage; 18
V3: voltage; 18
Named nets: V+, V-, 0
.tran 0 10u 0 1u
.model D D(Ron=1m Roff=10Meg Vfwd=17.3 Vrev=100)
.lib opamp.sub
