DumberThanUsual/EEE3-Instrumentation/PCB/Main Board/Main Board.kicad_pcb

## KiCad design PCB/Main Board/Main Board.kicad_pcb (2026-03-24)

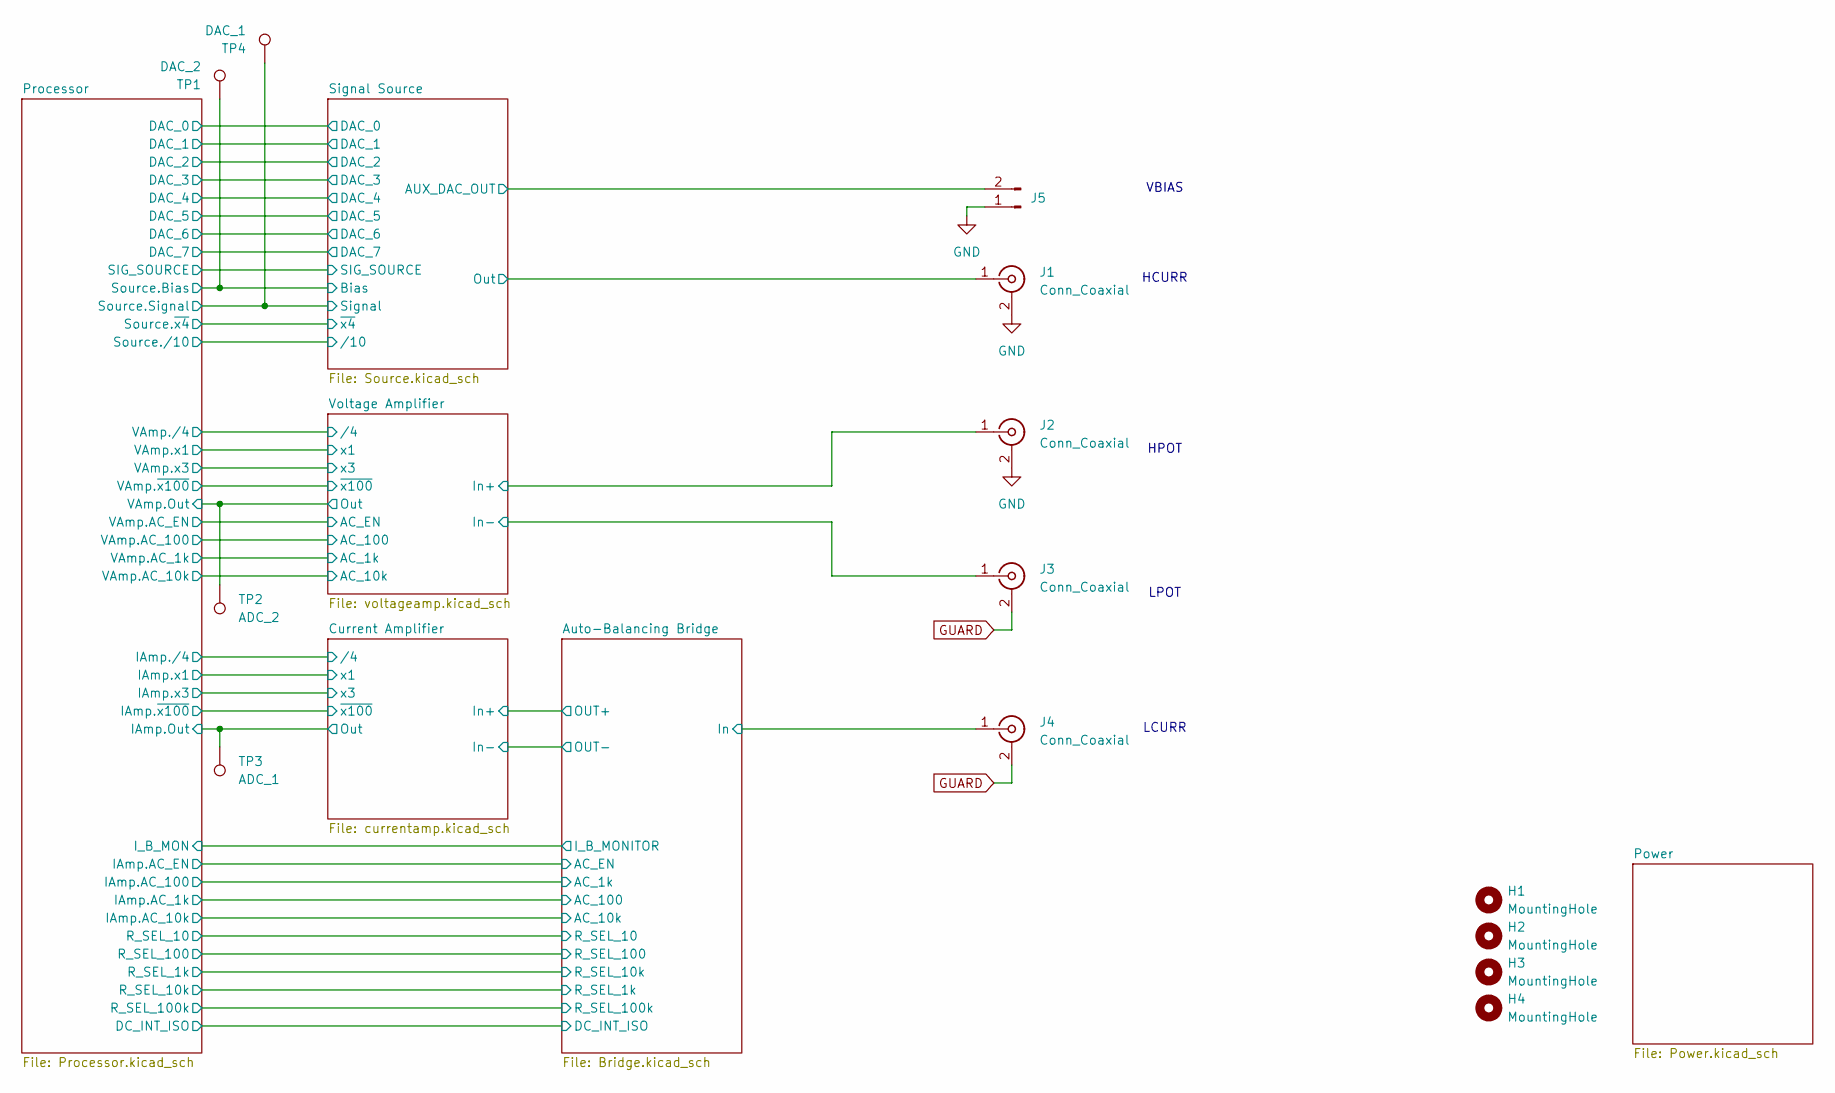
[picture p54: schematic Main Board.kicad_sch, Interconnect]

Parts:
H1, H2, H3, H4: MountingHole; MountingHole_3.2mm_M3
J1, J2, J3, J4: Conn_Coaxial; BNC_Amphenol_B6252HB-NPP3G-50_Horizontal
J5: Conn_01x02_Pin; PinHeader_1x02_P2.54mm_Vertical
TP1: DAC_2; TestPoint_Pad_2.0x2.0mm
TP2: ADC_2; TestPoint_Pad_2.0x2.0mm
TP3: ADC_1; TestPoint_Pad_2.0x2.0mm
TP4: DAC_1; TestPoint_Pad_2.0x2.0mm

Connections:
/Auto-Balancing Bridge/In: J4.1 (In); also elsewhere on the board
/Current Amplifier/Out: TP3.1; also elsewhere on the board
/Processor/Source.Bias: TP1.1; also elsewhere on the board
/Processor/Source.Signal: TP4.1; also elsewhere on the board
/Processor/VAmp.Out: TP2.1; also elsewhere on the board
/Signal Source/AUX_DAC_OUT: J5.2; also elsewhere on the board
/Signal Source/Out: J1.1 (In); also elsewhere on the board
/Voltage Amplifier/In+: J2.1 (In); also elsewhere on the board
/Voltage Amplifier/In-: J3.1 (In); also elsewhere on the board
GND: J1.2 (Ext), J2.2 (Ext), J5.1; also elsewhere on the board
GUARD: J3.2 (Ext), J4.2 (Ext); also elsewhere on the board

Notes on the sheet:
LPOT
HCURR
VBIAS
LCURR
HPOT

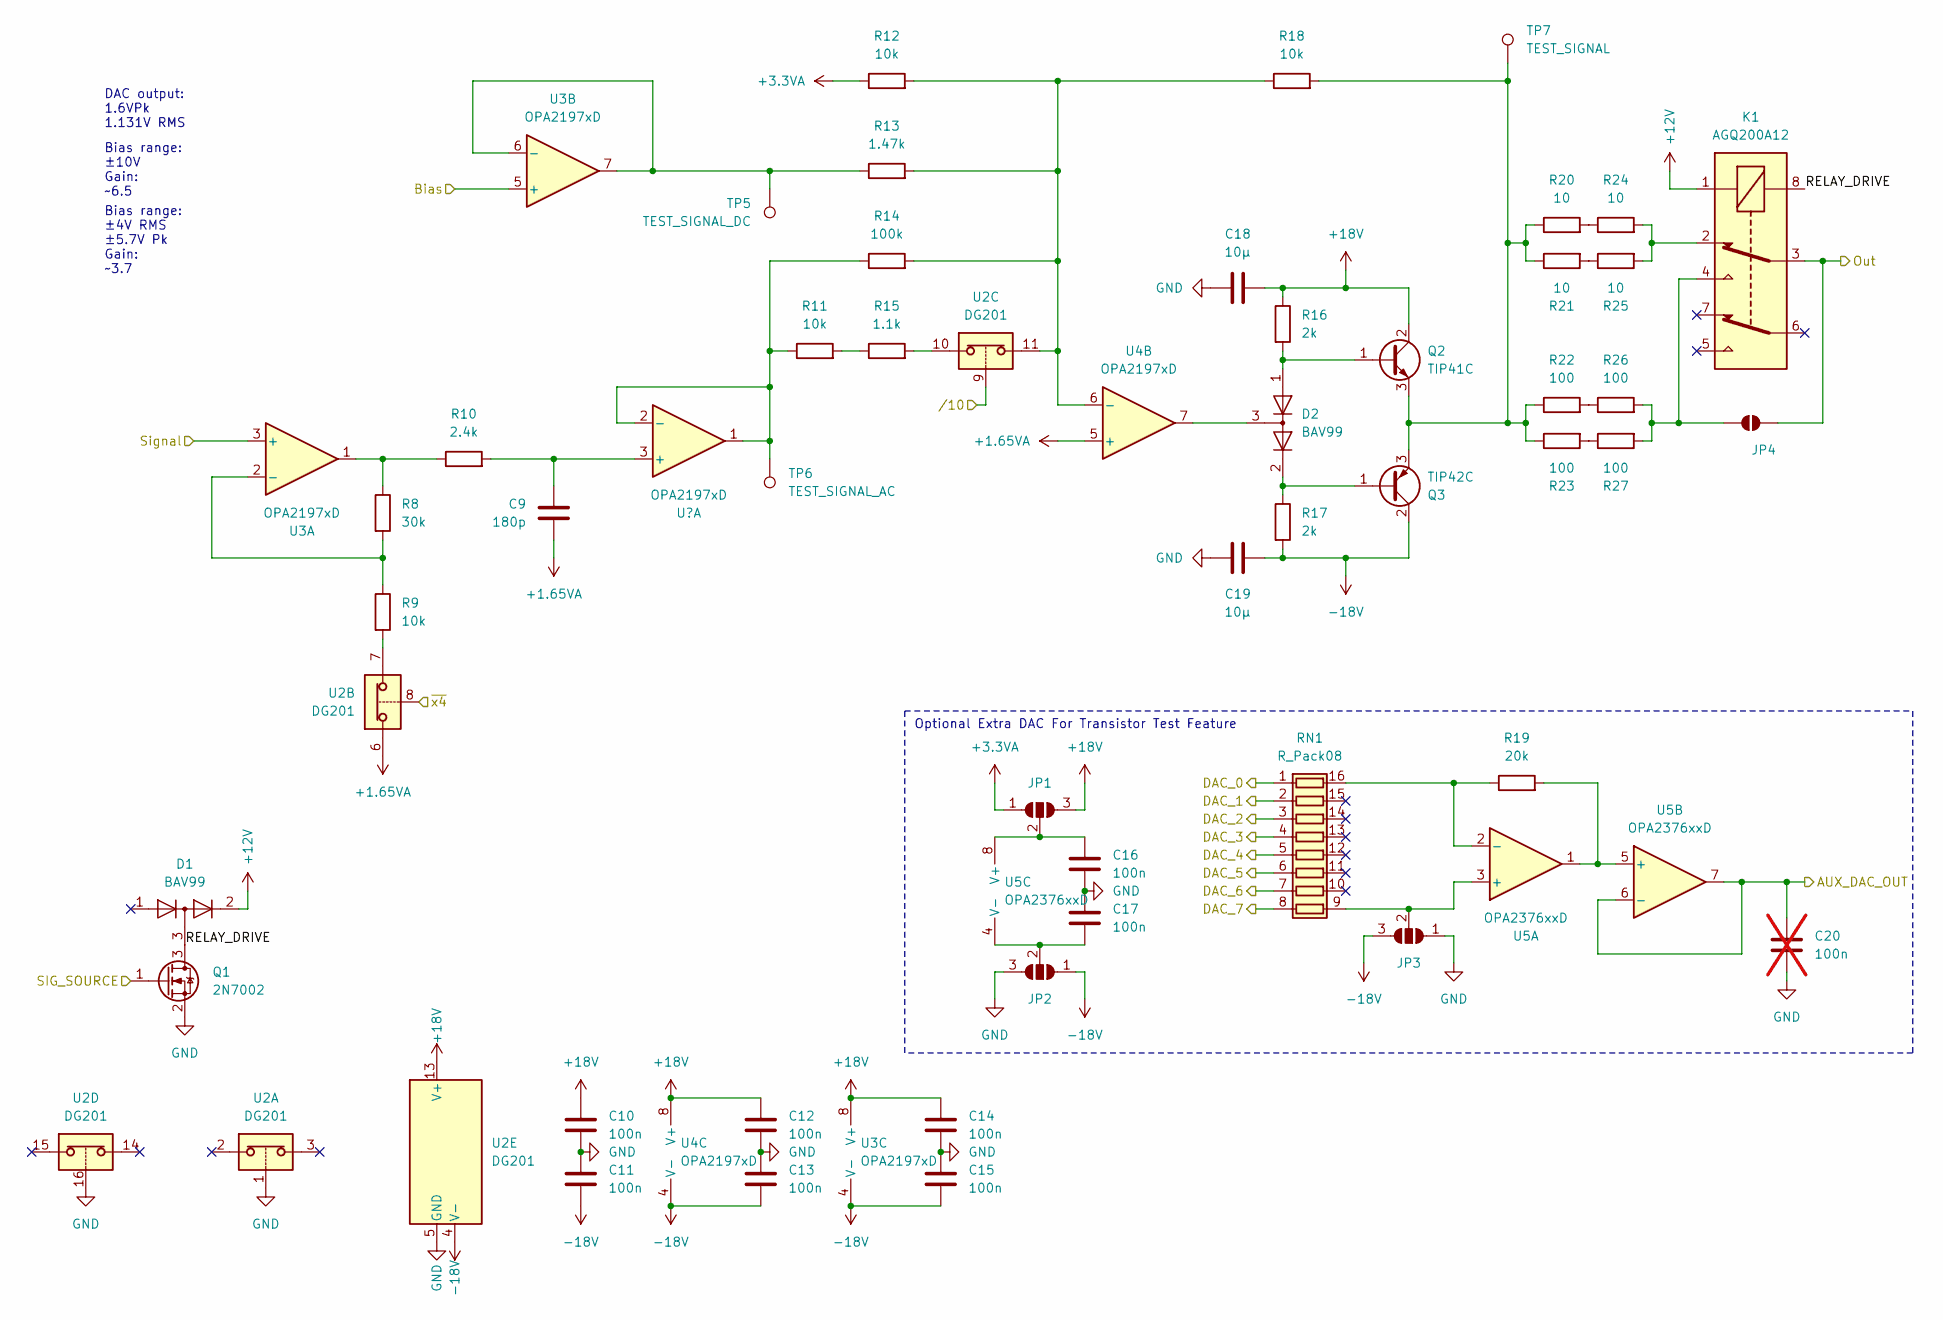
[picture p55: schematic Source.kicad_sch, Signal Source]

Parts:
C9: 180p; C_0805_2012Metric
C10, C11, C12, C13, C14, C15, C16, C17: 100n; C_0805_2012Metric
C18, C19: 10µ; C_0805_2012Metric
C20: 100n; C_0805_2012Metric; not fitted
D1, D2: BAV99; SOT-23
JP1, JP2, JP3: SolderJumper_3_Open; SolderJumper-3_P1.3mm_Open_RoundedPad1.0x1.5mm
JP4: SolderJumper_2_Open; SolderJumper-2_P1.3mm_Open_RoundedPad1.0x1.5mm
K1: AGQ200A12; RELAY_AGQ_A_PAN; Mouser Part Number 769-AGQ200A12
Q1: 2N7002; SOT-23
Q2: TIP41C; TO-220-3_Vertical
Q3: TIP42C; TO-220-3_Vertical
R8: 30k; R_0805_2012Metric
R9, R11, R12, R18: 10k; R_0805_2012Metric
R10: 2.4k; R_0805_2012Metric
R13: 1.47k; R_0805_2012Metric
R14: 100k; R_0805_2012Metric
R15: 1.1k; R_0805_2012Metric
R16, R17: 2k; R_0805_2012Metric
R19: 20k; R_0805_2012Metric
R20, R21, R24, R25: 10; R_2512_6332Metric
R22, R23, R26, R27: 100; R_0805_2012Metric
RN1: R_Pack08; SOIC-16_3.9x9.9mm_P1.27mm
TP5: TEST_SIGNAL_DC; TestPoint_Pad_2.0x2.0mm
TP6: TEST_SIGNAL_AC; TestPoint_Pad_2.0x2.0mm
TP7: TEST_SIGNAL; TestPoint_Pad_2.0x2.0mm
U2: DG201; SOIC-16_3.9x9.9mm_P1.27mm
U3, U4: OPA2197xD; SOIC-8_3.9x4.9mm_P1.27mm
U5: OPA2376xxD; SOIC-8_3.9x4.9mm_P1.27mm

Connections:
+1.65VA: C9.2, U2.6, U4.3 (+), U4.5 (+); also elsewhere on the board
+3.3VA: JP1.1 (A), R12.1; also elsewhere on the board
+12V: D1.2 (A), K1.1; also elsewhere on the board
+18V: C10.1, C12.1, C14.1, C18.2, JP1.3 (B), Q2.2 (C), R16.1, U2.13 (V+), U3.8 (V+), U4.8 (V+); also elsewhere on the board
-18V: C11.2, C13.2, C15.2, C19.2, JP2.1 (A), JP3.3 (B), Q3.2 (C), R17.2, U2.4 (V-), U3.4 (V-), U4.4 (V-); also elsewhere on the board
/Processor/DAC_0: RN1.1 (R1.1); also elsewhere on the board
/Processor/DAC_1: RN1.2 (R2.1); also elsewhere on the board
/Processor/DAC_2: RN1.3 (R3.1); also elsewhere on the board
/Processor/DAC_3: RN1.4 (R4.1); also elsewhere on the board
/Processor/DAC_4: RN1.5 (R5.1); also elsewhere on the board
/Processor/DAC_5: RN1.6 (R6.1); also elsewhere on the board
/Processor/DAC_6: RN1.7 (R7.1); also elsewhere on the board
/Processor/DAC_7: RN1.8 (R8.1); also elsewhere on the board
/Processor/SIG_SOURCE: Q1.1 (G); also elsewhere on the board
/Processor/Source.Bias: U3.5 (+); also elsewhere on the board
/Processor/Source.Signal: U3.3 (+); also elsewhere on the board
/Processor/Source./10: U2.9; also elsewhere on the board
/Processor/Source.~x4: U2.8; also elsewhere on the board
/Signal Source/AUX_DAC_OUT: C20.1, U5.6 (-), U5.7; also elsewhere on the board
/Signal Source/Out: JP4.1 (A), K1.3; also elsewhere on the board
/Signal Source/RELAY_DRIVE: D1.3 (K), K1.8, Q1.3 (D)
GND: C10.2, C11.1, C12.2, C13.1, C14.2, C15.1, C16.2, C17.1, C18.1, C19.1, C20.2, JP2.3 (B), JP3.1 (A), Q1.2 (S), U2.1, U2.5 (GND), U2.16; also elsewhere on the board
unnamed: D2.2 (A), Q3.1 (B), R17.1
unnamed: D2.3 (K), U4.7
unnamed: C16.1, JP1.2 (C), U5.8 (V+)
unnamed: C17.2, JP2.2 (C), U5.4 (V-)
unnamed: JP3.2 (C), RN1.9 (R8.2), U5.3 (+)
unnamed: JP4.2 (B), K1.4, R26.2, R27.2
unnamed: K1.2, R24.2, R25.2
unnamed: D2.1 (K), Q2.1 (B), R16.2
unnamed: Q2.3 (E), Q3.3 (E), R18.2, R20.1, R21.1, R22.1, R23.1, TP7.1
unnamed: R9.2, U2.7
unnamed: R8.1, R10.1, U3.1
unnamed: R11.1, R14.1, TP6.1, U4.1
unnamed: R11.2, R15.1
unnamed: R15.2, U2.10
unnamed: R20.2, R24.1
unnamed: R21.2, R25.1
unnamed: R22.2, R26.1
unnamed: R23.2, R27.1
unnamed: R19.1, RN1.16 (R1.2), U5.2 (-)
unnamed: R8.2, R9.1, U3.2 (-)
unnamed: R13.1, TP5.1, U3.6 (-), U3.7
unnamed: C9.1, R10.2, U4.2 (-)
unnamed: R12.2, R13.2, R14.2, R18.1, U2.11, U4.6 (-)
unnamed: R19.2, U5.1, U5.5 (+)

Notes on the sheet:
Optional Extra DAC For Transistor Test Feature
Bias range: ±10V Gain: ~6.5
DAC output: 1.6VPk 1.131V RMS
Bias range: ±4V RMS ±5.7V Pk Gain: ~3.7

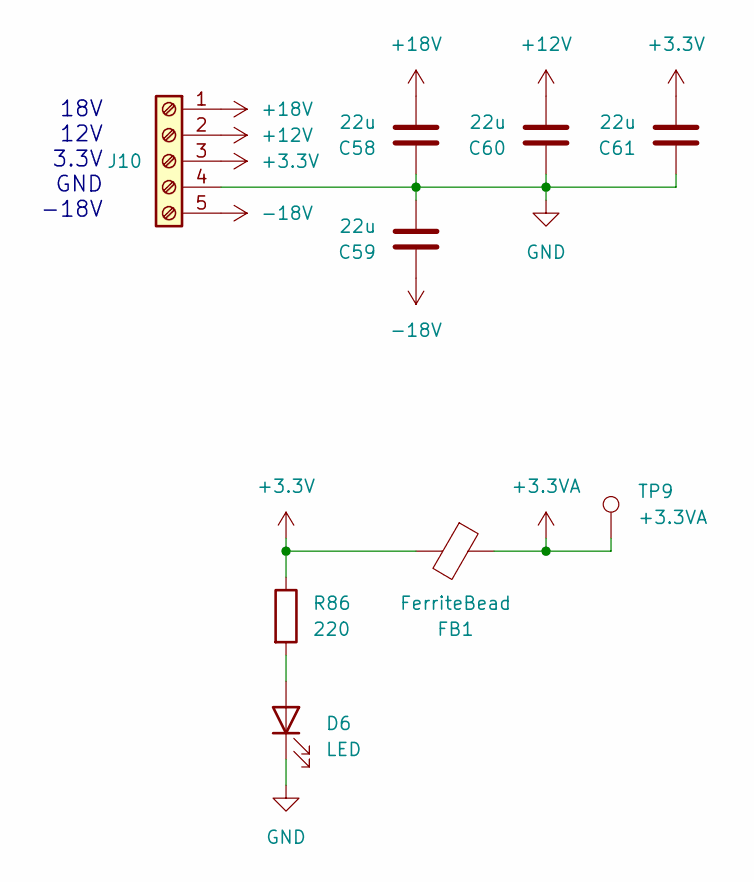
[picture p56: schematic Power.kicad_sch, Power Supply]

Parts:
C58, C59, C60, C61: 22u; C_1210_3225Metric
D6: LED; LED_0805_2012Metric
FB1: FerriteBead; L_0805_2012Metric
J10: Screw_Terminal_01x05; TerminalBlock_Phoenix_MKDS-1,5-5_1x05_P5.00mm_Horizontal
R86: 220; R_0805_2012Metric
TP9: +3.3VA; TestPoint_Pad_2.0x2.0mm

Connections:
+3.3V: C61.2, FB1.2, J10.3, R86.1; also elsewhere on the board
+3.3VA: FB1.1, TP9.1; also elsewhere on the board
+12V: C60.2, J10.2; also elsewhere on the board
+18V: C58.2, J10.1; also elsewhere on the board
-18V: C59.1, J10.5; also elsewhere on the board
GND: C58.1, C59.2, C60.1, C61.1, D6.1 (K), J10.4; also elsewhere on the board
unnamed: D6.2 (A), R86.2

Notes on the sheet:
18V 12V 3.3V GND -18V

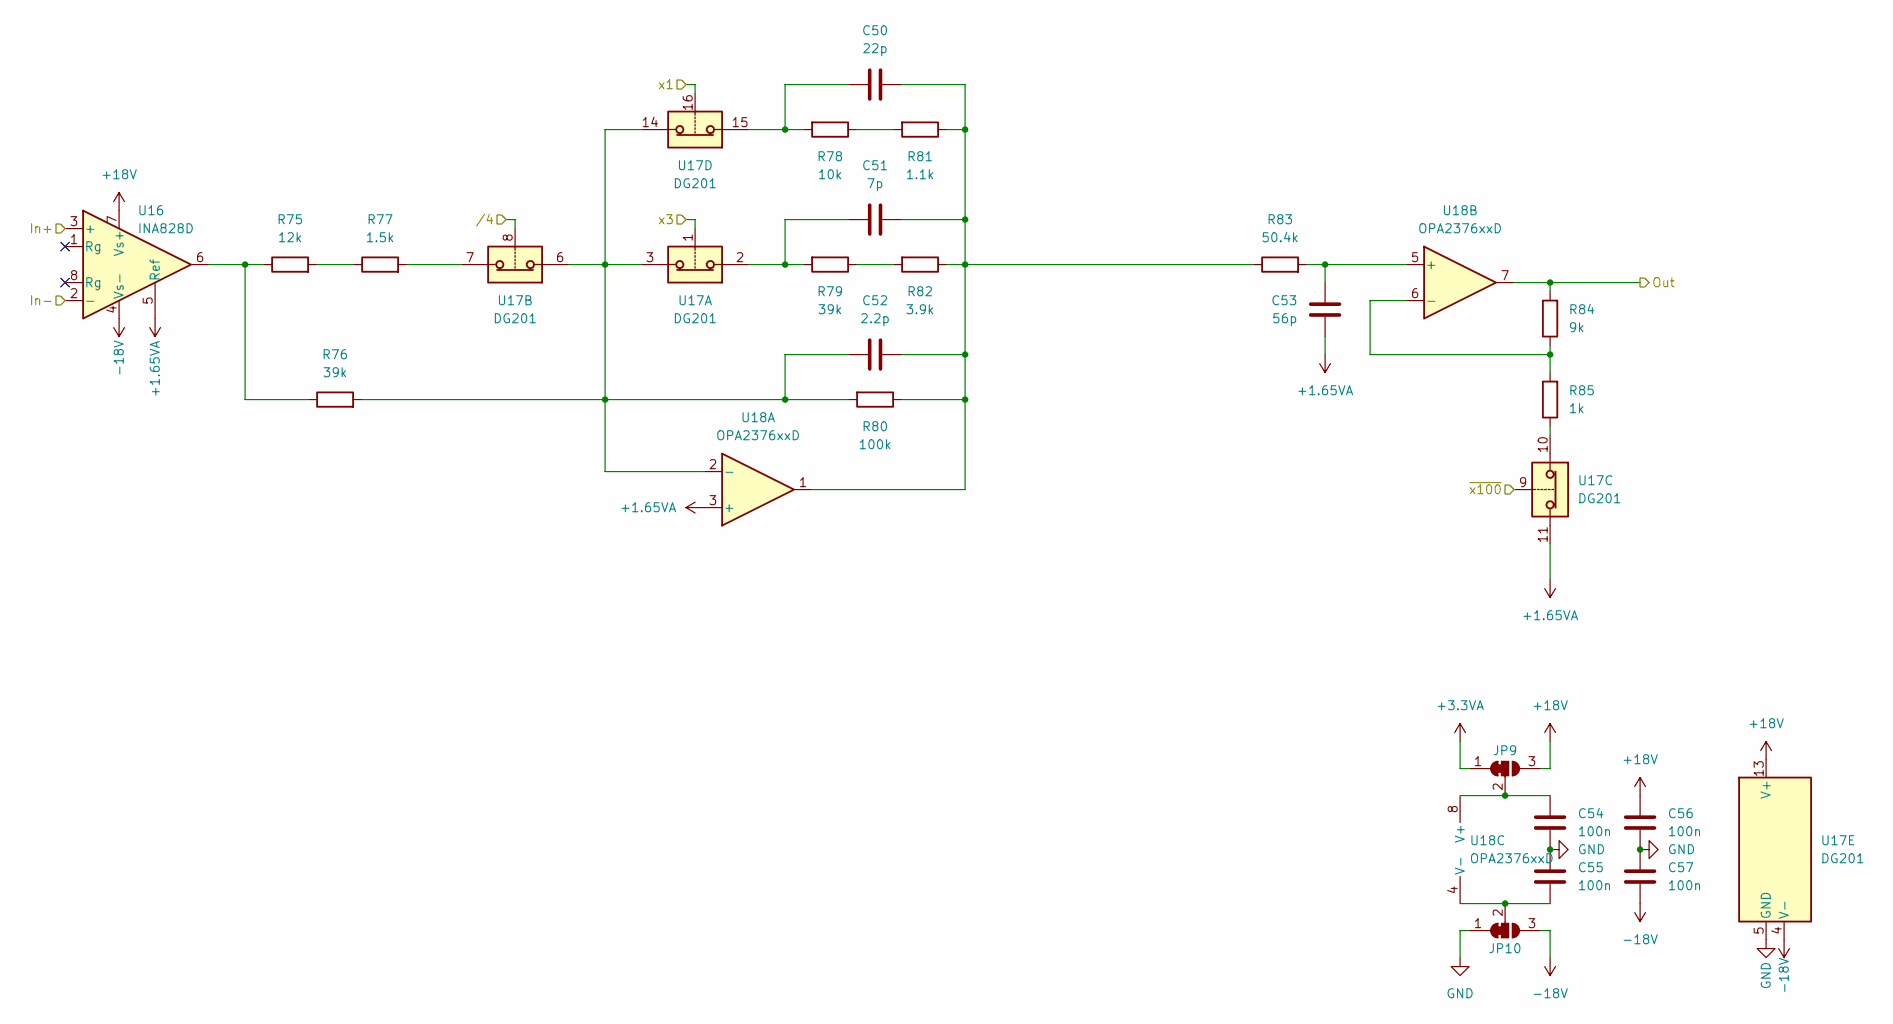
[picture p57: schematic currentamp.kicad_sch, Current Amplifier]

Parts:
C50: 22p; C_0805_2012Metric
C51: 7p; C_0805_2012Metric
C52: 2.2p; C_0805_2012Metric
C53: 56p; C_0805_2012Metric
C54, C55, C56, C57: 100n; C_0805_2012Metric
JP9, JP10: SolderJumper_3_Bridged12; SolderJumper-3_P1.3mm_Bridged12_RoundedPad1.0x1.5mm
R75: 12k; R_0805_2012Metric
R76, R79: 39k; R_0805_2012Metric
R77: 1.5k; R_0805_2012Metric
R78: 10k; R_0805_2012Metric
R80: 100k; R_0805_2012Metric
R81: 1.1k; R_0805_2012Metric
R82: 3.9k; R_0805_2012Metric
R83: 50.4k; R_0805_2012Metric
R84: 9k; R_0805_2012Metric
R85: 1k; R_0805_2012Metric
U16: INA828D; SOIC-8_3.9x4.9mm_P1.27mm
U17: DG201; SOIC-16_3.9x9.9mm_P1.27mm
U18: OPA2376xxD; SOIC-8_3.9x4.9mm_P1.27mm

Connections:
+1.65VA: C53.2, U16.5 (Ref), U17.11, U18.3 (+); also elsewhere on the board
+3.3VA: JP9.1 (A); also elsewhere on the board
+18V: C56.1, JP9.3 (B), U16.7 (Vs+), U17.13 (V+); also elsewhere on the board
-18V: C57.2, JP10.3 (B), U16.4 (Vs-), U17.4 (V-); also elsewhere on the board
/Auto-Balancing Bridge/In: U16.3 (+); also elsewhere on the board
/Auto-Balancing Bridge/OUT+: U16.2 (-); also elsewhere on the board
/Current Amplifier/Out: R84.2, U18.7; also elsewhere on the board
/Current Amplifier/x1: U17.16; also elsewhere on the board
/Current Amplifier/x3: U17.1; also elsewhere on the board
/Current Amplifier//4: U17.8; also elsewhere on the board
/Current Amplifier/~x100: U17.9; also elsewhere on the board
GND: C54.2, C55.1, C56.2, C57.1, JP10.1 (A), U17.5 (GND); also elsewhere on the board
unnamed: C50.1, R78.2, U17.15
unnamed: C50.2, C51.2, C52.2, R80.1, R81.1, R82.1, R83.1, U18.1
unnamed: C51.1, R79.2, U17.2
unnamed: C54.1, JP9.2 (C), U18.8 (V+)
unnamed: C55.2, JP10.2 (C), U18.4 (V-)
unnamed: R75.1, R76.1, U16.6
unnamed: R75.2, R77.1
unnamed: R77.2, U17.7
unnamed: R78.1, R81.2
unnamed: R79.1, R82.2
unnamed: R85.1, U17.10
unnamed: C52.1, R76.2, R80.2, U17.3, U17.6, U17.14, U18.2 (-)
unnamed: C53.1, R83.2, U18.5 (+)
unnamed: R84.1, R85.2, U18.6 (-)

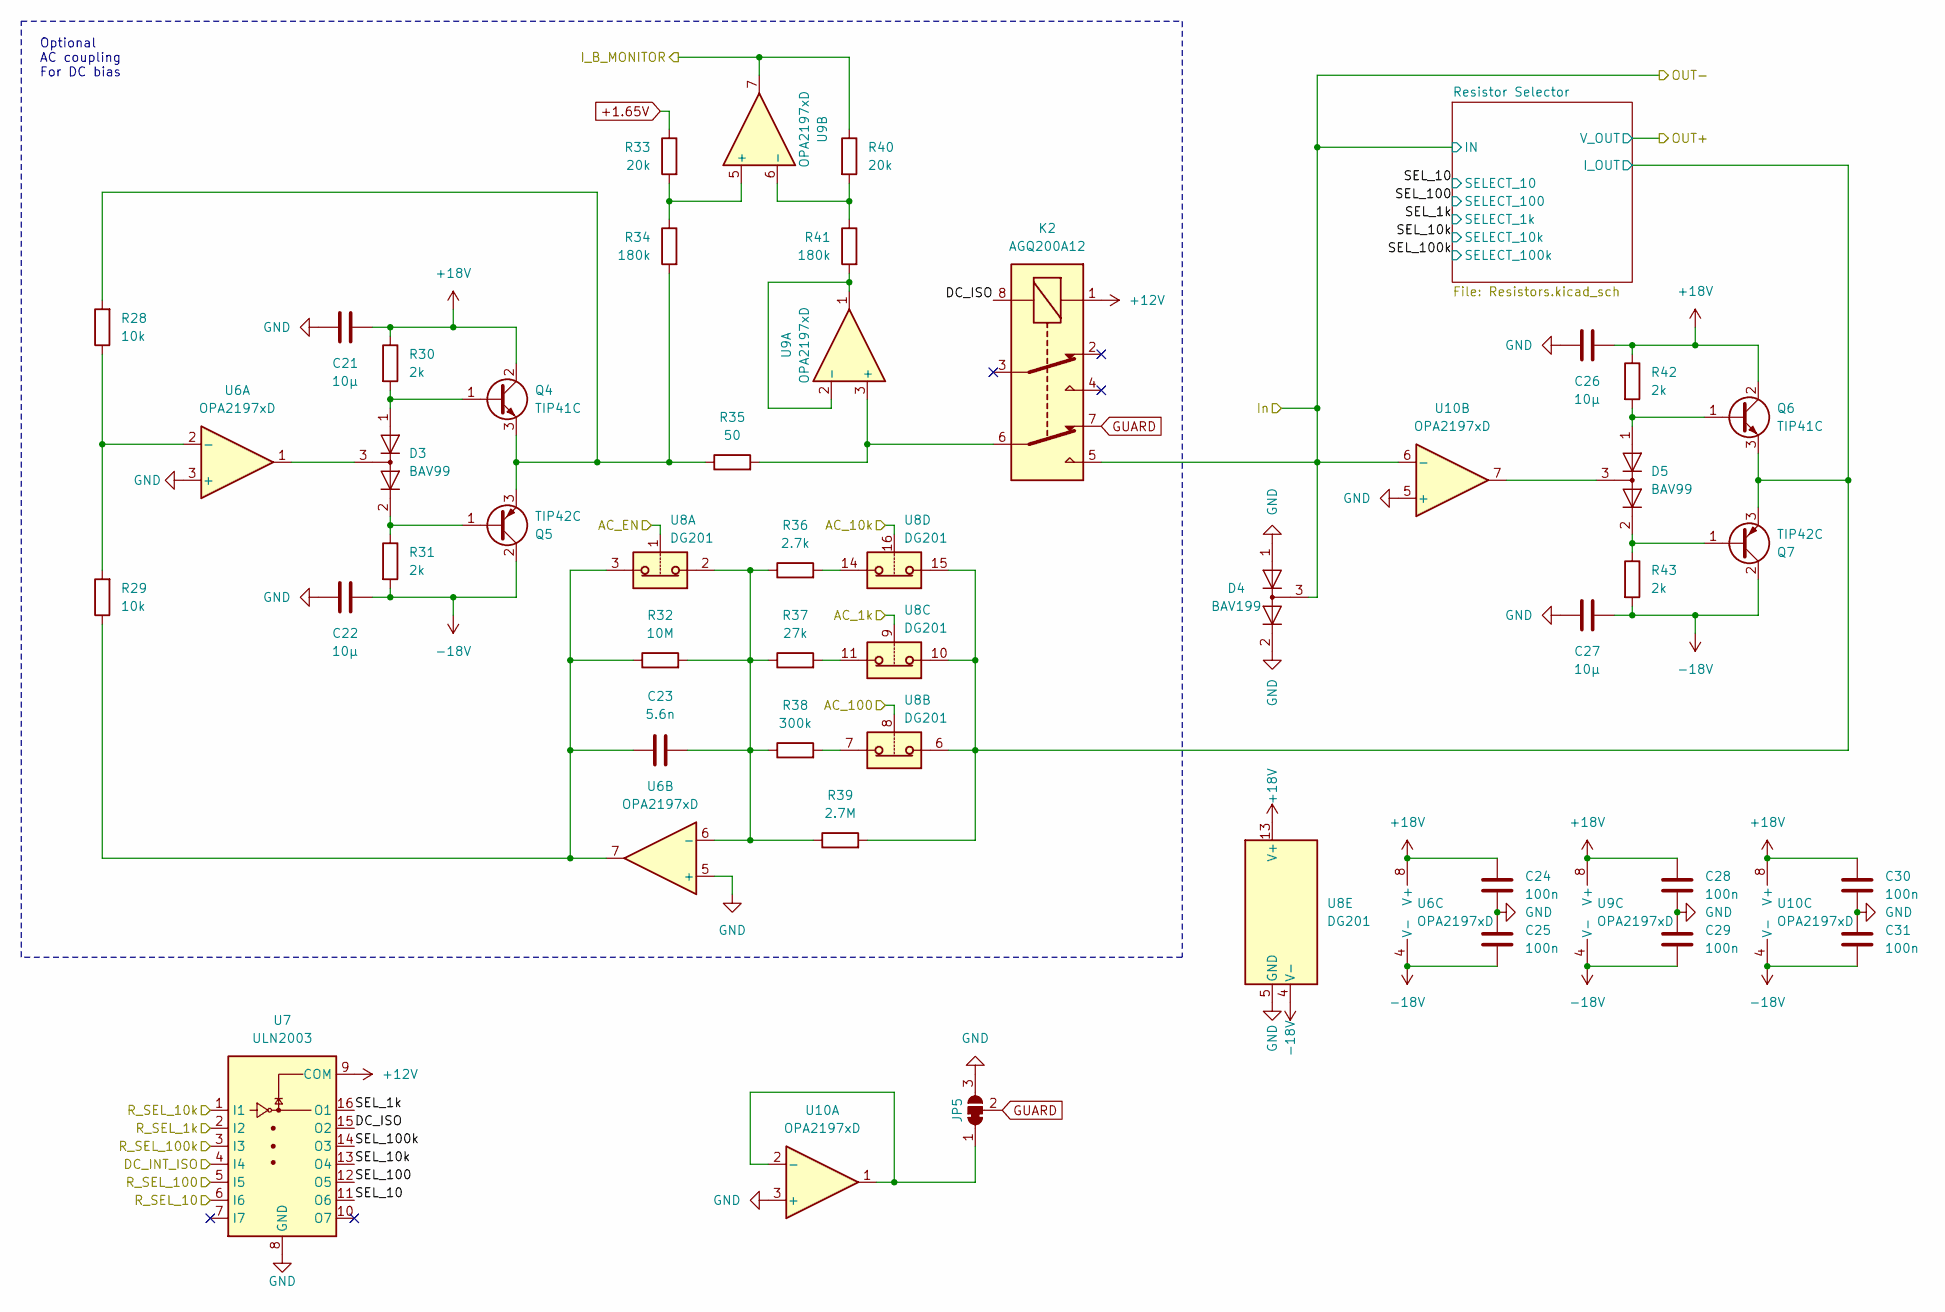
[picture p58: schematic Bridge.kicad_sch, Auto-Balancing Bridge]

Parts:
C21, C22, C26, C27: 10µ; C_0805_2012Metric
C23: 5.6n; C_0805_2012Metric
C24, C25, C28, C29, C30, C31: 100n; C_0805_2012Metric
D3, D5: BAV99; SOT-23
D4: BAV199; SOT-23
JP5: SolderJumper_3_Bridged12; SolderJumper-3_P1.3mm_Bridged12_RoundedPad1.0x1.5mm
K2: AGQ200A12; RELAY_AGQ_A_PAN; Mouser Part Number 769-AGQ200A12
Q4, Q6: TIP41C; TO-220-3_Vertical
Q5, Q7: TIP42C; TO-220-3_Vertical
R28, R29: 10k; R_0805_2012Metric
R30, R31, R42, R43: 2k; R_0805_2012Metric
R32: 10M; R_0805_2012Metric
R33, R40: 20k; R_0805_2012Metric
R34, R41: 180k; R_0805_2012Metric
R35: 50; R_0805_2012Metric
R36: 2.7k; R_0805_2012Metric
R37: 27k; R_0805_2012Metric
R38: 300k; R_0805_2012Metric
R39: 2.7M; R_0805_2012Metric
U6, U9, U10: OPA2197xD; SOIC-8_3.9x4.9mm_P1.27mm
U7: ULN2003; SOIC-16_3.9x9.9mm_P1.27mm
U8: DG201; SOIC-16_3.9x9.9mm_P1.27mm

Connections:
+1.65V: R33.1
+12V: K2.1, U7.9 (COM); also elsewhere on the board
+18V: C21.2, C24.1, C26.2, C28.1, C30.1, Q4.2 (C), Q6.2 (C), R30.1, R42.1, U6.8 (V+), U8.13 (V+), U9.8 (V+), U10.8 (V+); also elsewhere on the board
-18V: C22.2, C25.2, C27.2, C29.2, C31.2, Q5.2 (C), Q7.2 (C), R31.2, R43.2, U6.4 (V-), U8.4 (V-), U9.4 (V-), U10.4 (V-); also elsewhere on the board
/Auto-Balancing Bridge/AC_1k: U8.9; also elsewhere on the board
/Auto-Balancing Bridge/AC_10k: U8.16; also elsewhere on the board
/Auto-Balancing Bridge/AC_100: U8.8; also elsewhere on the board
/Auto-Balancing Bridge/AC_EN: U8.1; also elsewhere on the board
/Auto-Balancing Bridge/DC_INT_ISO: U7.4 (I4); also elsewhere on the board
/Auto-Balancing Bridge/DC_ISO: K2.8, U7.15 (O2)
/Auto-Balancing Bridge/I_B_MONITOR: R40.1, U9.7; also elsewhere on the board
/Auto-Balancing Bridge/In: D4.3 (K), K2.5, U10.6 (-); also elsewhere on the board
/Auto-Balancing Bridge/OUT+: Q6.3 (E), Q7.3 (E), R39.2, U8.6, U8.10, U8.15; also elsewhere on the board
/Auto-Balancing Bridge/R_SEL_1k: U7.2 (I2); also elsewhere on the board
/Auto-Balancing Bridge/R_SEL_10: U7.6 (I6); also elsewhere on the board
/Auto-Balancing Bridge/R_SEL_10k: U7.1 (I1); also elsewhere on the board
/Auto-Balancing Bridge/R_SEL_100: U7.5 (I5); also elsewhere on the board
/Auto-Balancing Bridge/R_SEL_100k: U7.3 (I3); also elsewhere on the board
/Auto-Balancing Bridge/SEL_1k: U7.16 (O1); also elsewhere on the board
/Auto-Balancing Bridge/SEL_10: U7.11 (O6); also elsewhere on the board
/Auto-Balancing Bridge/SEL_10k: U7.13 (O4); also elsewhere on the board
/Auto-Balancing Bridge/SEL_100: U7.12 (O5); also elsewhere on the board
/Auto-Balancing Bridge/SEL_100k: U7.14 (O3); also elsewhere on the board
GND: C21.1, C22.1, C24.2, C25.1, C26.1, C27.1, C28.2, C29.1, C30.2, C31.1, D4.1 (K), D4.2 (A), JP5.3 (B), U6.3 (+), U6.5 (+), U7.8 (GND), U8.5 (GND), U10.3 (+), U10.5 (+); also elsewhere on the board
GUARD: JP5.2 (C), K2.7; also elsewhere on the board
unnamed: C23.1, R29.1, R32.1, U6.7, U8.3
unnamed: D3.2 (A), Q5.1 (B), R31.1
unnamed: D3.3 (K), U6.1
unnamed: D5.2 (A), Q7.1 (B), R43.1
unnamed: D5.3 (K), U10.7
unnamed: JP5.1 (A), U10.1, U10.2 (-)
unnamed: D3.1 (K), Q4.1 (B), R30.2
unnamed: Q4.3 (E), Q5.3 (E), R28.2, R34.2, R35.1
unnamed: D5.1 (K), Q6.1 (B), R42.2
unnamed: R36.2, U8.14
unnamed: R37.2, U8.11
unnamed: R38.2, U8.7
unnamed: R28.1, R29.2, U6.2 (-)
unnamed: C23.2, R32.2, R36.1, R37.1, R38.1, R39.1, U6.6 (-), U8.2
unnamed: K2.6, R35.2, U9.3 (+)
unnamed: R41.2, U9.1, U9.2 (-)
unnamed: R33.2, R34.1, U9.5 (+)
unnamed: R40.2, R41.1, U9.6 (-)

Notes on the sheet:
Optional AC coupling For DC bias

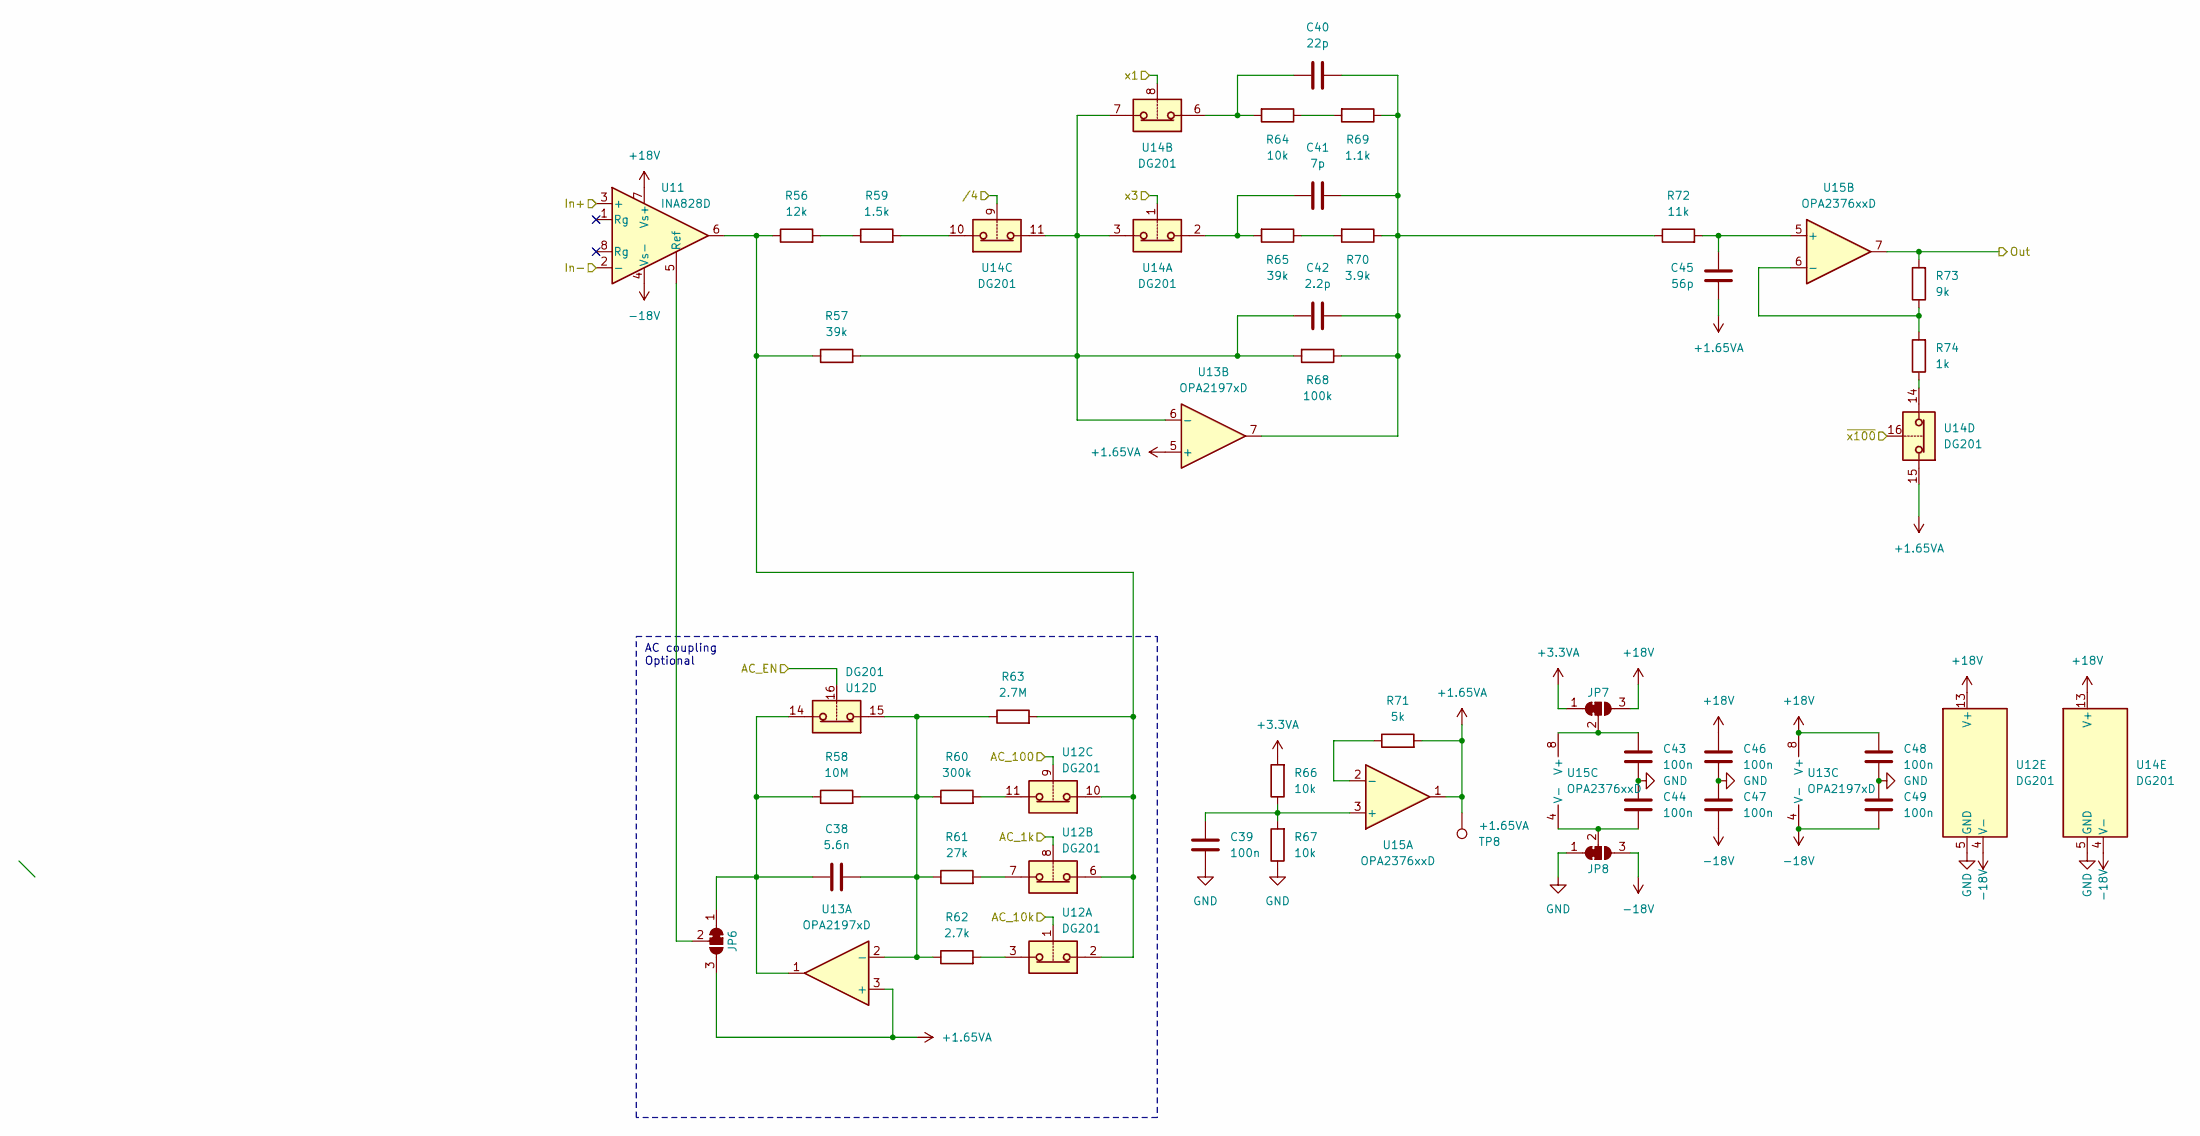
[picture p59: schematic voltageamp.kicad_sch, Voltage Amplifier]

Parts:
C38: 5.6n; C_0805_2012Metric
C39, C43, C44, C46, C47, C48, C49: 100n; C_0805_2012Metric
C40: 22p; C_0805_2012Metric
C41: 7p; C_0805_2012Metric
C42: 2.2p; C_0805_2012Metric
C45: 56p; C_0805_2012Metric
JP6, JP7, JP8: SolderJumper_3_Bridged12; SolderJumper-3_P1.3mm_Bridged12_RoundedPad1.0x1.5mm_NumberL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
R56: 12k; R_0805_2012Metric
R57, R65: 39k; R_0805_2012Metric
R58: 10M; R_0805_2012Metric
R59: 1.5k; R_0805_2012Metric
R60: 300k; R_0805_2012Metric
R61: 27k; R_0805_2012Metric
R62: 2.7k; R_0805_2012Metric
R63: 2.7M; R_0805_2012Metric
R64, R66, R67: 10k; R_0805_2012Metric
R68: 100k; R_0805_2012Metric
R69: 1.1k; R_0805_2012Metric
R70: 3.9k; R_0805_2012Metric
R71: 5k; R_0805_2012Metric
R72: 11k; R_0805_2012Metric
R73: 9k; R_0805_2012Metric
R74: 1k; R_0805_2012Metric
TP8: +1.65VA; TestPoint_Pad_2.0x2.0mm
U11: INA828D; SOIC-8_3.9x4.9mm_P1.27mm
U12, U14: DG201; SOIC-16_3.9x9.9mm_P1.27mm
U13: OPA2197xD; SOIC-8_3.9x4.9mm_P1.27mm
U15: OPA2376xxD; SOIC-8_3.9x4.9mm_P1.27mm

Connections:
+1.65VA: C45.2, JP6.3 (B), R71.2, TP8.1, U13.3 (+), U13.5 (+), U14.15, U15.1; also elsewhere on the board
+3.3VA: JP7.1 (A), R66.2; also elsewhere on the board
+18V: C46.1, C48.1, JP7.3 (B), U11.7 (Vs+), U12.13 (V+), U13.8 (V+), U14.13 (V+); also elsewhere on the board
-18V: C47.2, C49.2, JP8.3 (B), U11.4 (Vs-), U12.4 (V-), U13.4 (V-), U14.4 (V-); also elsewhere on the board
/Processor/VAmp.AC_1k: U12.8; also elsewhere on the board
/Processor/VAmp.AC_10k: U12.1; also elsewhere on the board
/Processor/VAmp.AC_100: U12.9; also elsewhere on the board
/Processor/VAmp.AC_EN: U12.16; also elsewhere on the board
/Processor/VAmp.Out: R73.2, U15.7; also elsewhere on the board
/Processor/VAmp.x1: U14.8; also elsewhere on the board
/Processor/VAmp.x3: U14.1; also elsewhere on the board
/Processor/VAmp./4: U14.9; also elsewhere on the board
/Processor/VAmp.~x100: U14.16; also elsewhere on the board
/Voltage Amplifier/In+: U11.3 (+); also elsewhere on the board
/Voltage Amplifier/In-: U11.2 (-); also elsewhere on the board
GND: C39.2, C43.2, C44.1, C46.2, C47.1, C48.2, C49.1, JP8.1 (A), R67.1, U12.5 (GND), U14.5 (GND); also elsewhere on the board
unnamed: C40.1, R64.2, U14.6
unnamed: C40.2, C41.2, C42.2, R68.1, R69.1, R70.1, R72.1, U13.7
unnamed: C41.1, R65.2, U14.2
unnamed: C38.1, JP6.1 (A), R58.1, U12.14, U13.1
unnamed: JP6.2 (C), U11.5 (Ref)
unnamed: C43.1, JP7.2 (C), U15.8 (V+)
unnamed: C44.2, JP8.2 (C), U15.4 (V-)
unnamed: R56.1, R57.1, R63.2, U11.6, U12.2, U12.6, U12.10
unnamed: R56.2, R59.1
unnamed: R59.2, U14.10
unnamed: R60.2, U12.11
unnamed: R61.2, U12.7
unnamed: R62.2, U12.3
unnamed: R64.1, R69.2
unnamed: R65.1, R70.2
unnamed: R74.1, U14.14
unnamed: C38.2, R58.2, R60.1, R61.1, R62.1, R63.1, U12.15, U13.2 (-)
unnamed: C42.1, R57.2, R68.2, U13.6 (-), U14.3, U14.7, U14.11
unnamed: C39.1, R66.1, R67.2, U15.3 (+)
unnamed: R71.1, U15.2 (-)
unnamed: C45.1, R72.2, U15.5 (+)
unnamed: R73.1, R74.2, U15.6 (-)

Notes on the sheet:
AC coupling Optional
