DumberThanUsual/EEE3-Instrumentation/PCB/Main Board/Main Board.kicad_pcb

## KiCad design PCB/Main Board/Main Board.kicad_pcb (continued)

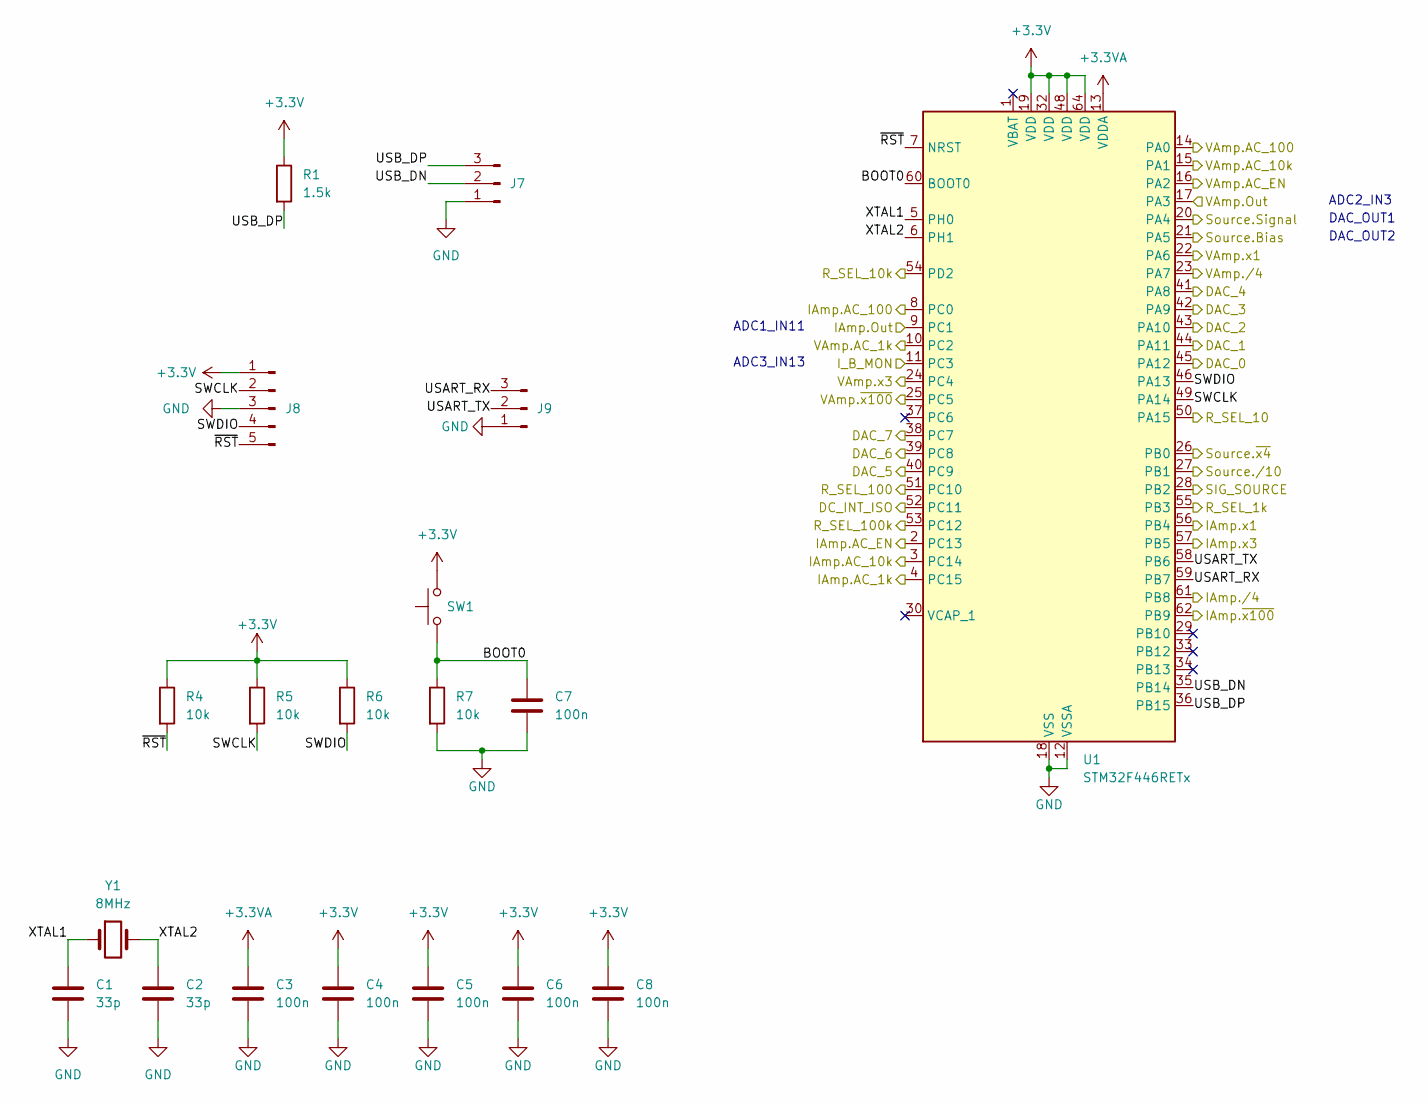
[picture p60: schematic Processor.kicad_sch]

Parts:
C1, C2: 33p; C_0805_2012Metric
C3, C4, C5, C6, C7, C8: 100n; C_0805_2012Metric
J7, J9: Conn_01x03_Pin; PinHeader_1x03_P2.54mm_Vertical
J8: Conn_01x05_Pin; PinHeader_1x05_P2.54mm_Vertical
R1: 1.5k; R_0805_2012Metric
R4, R5, R6, R7: 10k; R_0805_2012Metric
SW1: SW_Push; SW_PUSH_6mm
U1: STM32F446RETx; LQFP-64_10x10mm_P0.5mm
Y1: 8MHz; Crystal_SMD_5032-2Pin_5.0x3.2mm

Connections:
+3.3V: C4.1, C5.1, C6.1, C8.1, J8.1, R1.1, R4.1, R5.1, R6.1, SW1.2, U1.19 (VDD), U1.32 (VDD), U1.48 (VDD), U1.64 (VDD); also elsewhere on the board
+3.3VA: C3.1, U1.13 (VDDA); also elsewhere on the board
/Auto-Balancing Bridge/AC_1k: U1.8 (PC0); also elsewhere on the board
/Auto-Balancing Bridge/AC_10k: U1.3 (PC14); also elsewhere on the board
/Auto-Balancing Bridge/AC_100: U1.4 (PC15); also elsewhere on the board
/Auto-Balancing Bridge/AC_EN: U1.2 (PC13); also elsewhere on the board
/Auto-Balancing Bridge/DC_INT_ISO: U1.52 (PC11); also elsewhere on the board
/Auto-Balancing Bridge/I_B_MONITOR: U1.11 (PC3); also elsewhere on the board
/Auto-Balancing Bridge/R_SEL_1k: U1.54 (PD2); also elsewhere on the board
/Auto-Balancing Bridge/R_SEL_10: U1.50 (PA15); also elsewhere on the board
/Auto-Balancing Bridge/R_SEL_10k: U1.55 (PB3); also elsewhere on the board
/Auto-Balancing Bridge/R_SEL_100: U1.51 (PC10); also elsewhere on the board
/Auto-Balancing Bridge/R_SEL_100k: U1.53 (PC12); also elsewhere on the board
/Current Amplifier/Out: U1.9 (PC1); also elsewhere on the board
/Current Amplifier/x1: U1.56 (PB4); also elsewhere on the board
/Current Amplifier/x3: U1.57 (PB5); also elsewhere on the board
/Current Amplifier//4: U1.61 (PB8); also elsewhere on the board
/Current Amplifier/~x100: U1.62 (PB9); also elsewhere on the board
/Processor/BOOT0: C7.1, R7.1, SW1.1, U1.60 (BOOT0)
/Processor/DAC_0: U1.45 (PA12); also elsewhere on the board
/Processor/DAC_1: U1.44 (PA11); also elsewhere on the board
/Processor/DAC_2: U1.43 (PA10); also elsewhere on the board
/Processor/DAC_3: U1.42 (PA9); also elsewhere on the board
/Processor/DAC_4: U1.41 (PA8); also elsewhere on the board
/Processor/DAC_5: U1.40 (PC9); also elsewhere on the board
/Processor/DAC_6: U1.39 (PC8); also elsewhere on the board
/Processor/DAC_7: U1.38 (PC7); also elsewhere on the board
/Processor/SIG_SOURCE: U1.28 (PB2); also elsewhere on the board
/Processor/SWCLK: J8.2, R5.2, U1.49 (PA14)
/Processor/SWDIO: J8.4, R6.2, U1.46 (PA13)
/Processor/Source.Bias: U1.21 (PA5); also elsewhere on the board
/Processor/Source.Signal: U1.20 (PA4); also elsewhere on the board
/Processor/Source./10: U1.27 (PB1); also elsewhere on the board
/Processor/Source.~x4: U1.26 (PB0); also elsewhere on the board
/Processor/USART_RX: J9.3, U1.59 (PB7)
/Processor/USART_TX: J9.2, U1.58 (PB6)
/Processor/USB_DN: J7.2, U1.35 (PB14)
/Processor/USB_DP: J7.3, R1.2, U1.36 (PB15)
/Processor/VAmp.AC_1k: U1.10 (PC2); also elsewhere on the board
/Processor/VAmp.AC_10k: U1.15 (PA1); also elsewhere on the board
/Processor/VAmp.AC_100: U1.14 (PA0); also elsewhere on the board
/Processor/VAmp.AC_EN: U1.16 (PA2); also elsewhere on the board
/Processor/VAmp.Out: U1.17 (PA3); also elsewhere on the board
/Processor/VAmp.x1: U1.22 (PA6); also elsewhere on the board
/Processor/VAmp.x3: U1.24 (PC4); also elsewhere on the board
/Processor/VAmp./4: U1.23 (PA7); also elsewhere on the board
/Processor/VAmp.~x100: U1.25 (PC5); also elsewhere on the board
/Processor/XTAL1: C1.1, U1.5 (PH0), Y1.1
/Processor/XTAL2: C2.1, U1.6 (PH1), Y1.2
/Processor/~RST: J8.5, R4.2, U1.7 (NRST)
GND: C1.2, C2.2, C3.2, C4.2, C5.2, C6.2, C7.2, C8.2, J7.1, J8.3, J9.1, R7.2, U1.12 (VSSA), U1.18 (VSS), U1.31 (VSS), U1.47 (VSS), U1.63 (VSS); also elsewhere on the board

Notes on the sheet:
DAC_OUT1
ADC1_IN11
ADC2_IN3
DAC_OUT2
ADC3_IN13

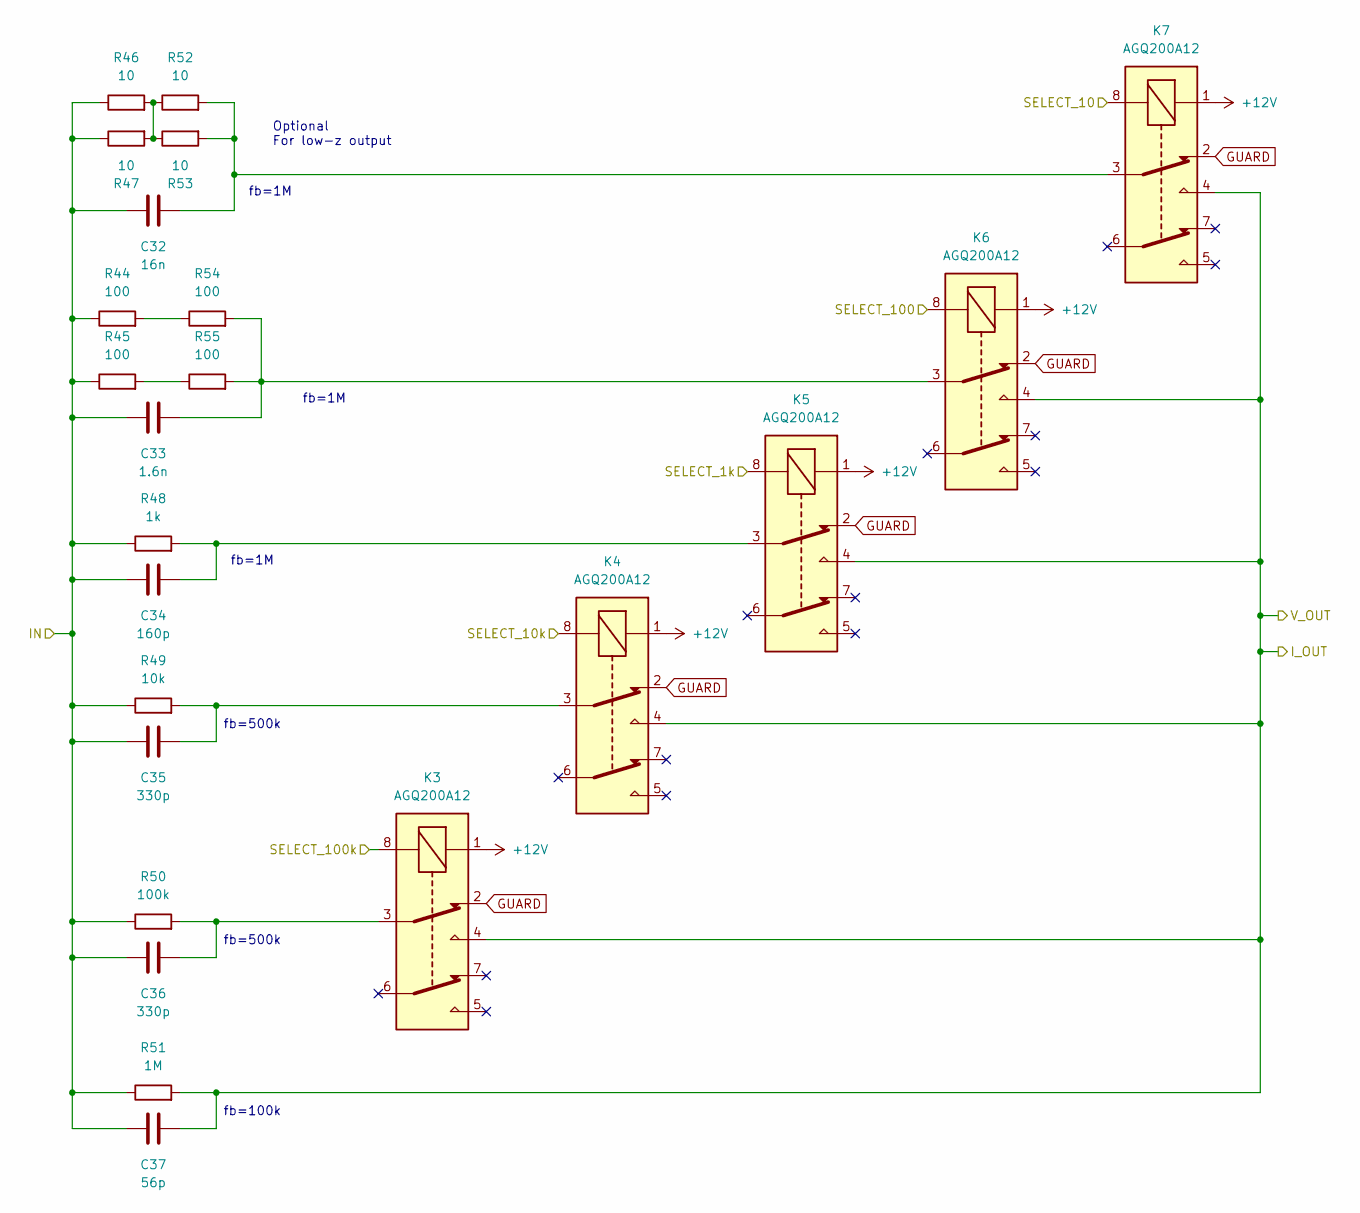
[picture p61: schematic Resistors.kicad_sch, Resistor Selector]

Parts:
C32: 16n; C_0805_2012Metric
C33: 1.6n; C_0805_2012Metric
C34: 160p; C_0805_2012Metric
C35, C36: 330p; C_0805_2012Metric
C37: 56p; C_0805_2012Metric
K3, K4, K5, K6, K7: AGQ200A12; RELAY_AGQ_A_PAN; Mouser Part Number 769-AGQ200A12
R44, R45, R54, R55: 100; R_0805_2012Metric
R46, R47, R52, R53: 10; R_2512_6332Metric
R48: 1k; R_0805_2012Metric
R49: 10k; R_0805_2012Metric
R50: 100k; R_0805_2012Metric
R51: 1M; R_0805_2012Metric

Connections:
+12V: K3.1, K4.1, K5.1, K6.1, K7.1; also elsewhere on the board
/Auto-Balancing Bridge/In: C32.1, C33.1, C34.1, C35.1, C36.1, C37.1, R44.1, R45.1, R46.1, R47.1, R48.1, R49.1, R50.1, R51.1; also elsewhere on the board
/Auto-Balancing Bridge/OUT+: C37.2, K3.4, K4.4, K5.4, K6.4, K7.4, R51.2; also elsewhere on the board
/Auto-Balancing Bridge/SEL_1k: K5.8; also elsewhere on the board
/Auto-Balancing Bridge/SEL_10: K7.8; also elsewhere on the board
/Auto-Balancing Bridge/SEL_10k: K4.8; also elsewhere on the board
/Auto-Balancing Bridge/SEL_100: K6.8; also elsewhere on the board
/Auto-Balancing Bridge/SEL_100k: K3.8; also elsewhere on the board
GUARD: K3.2, K4.2, K5.2, K6.2, K7.2; also elsewhere on the board
unnamed: C32.2, K7.3, R52.2, R53.2
unnamed: C33.2, K6.3, R54.2, R55.2
unnamed: C34.2, K5.3, R48.2
unnamed: C35.2, K4.3, R49.2
unnamed: C36.2, K3.3, R50.2
unnamed: R44.2, R54.1
unnamed: R45.2, R55.1
unnamed: R46.2, R47.2, R52.1, R53.1

Notes on the sheet:
fb=100k
fb=500k
fb=1M
Optional For low-z output

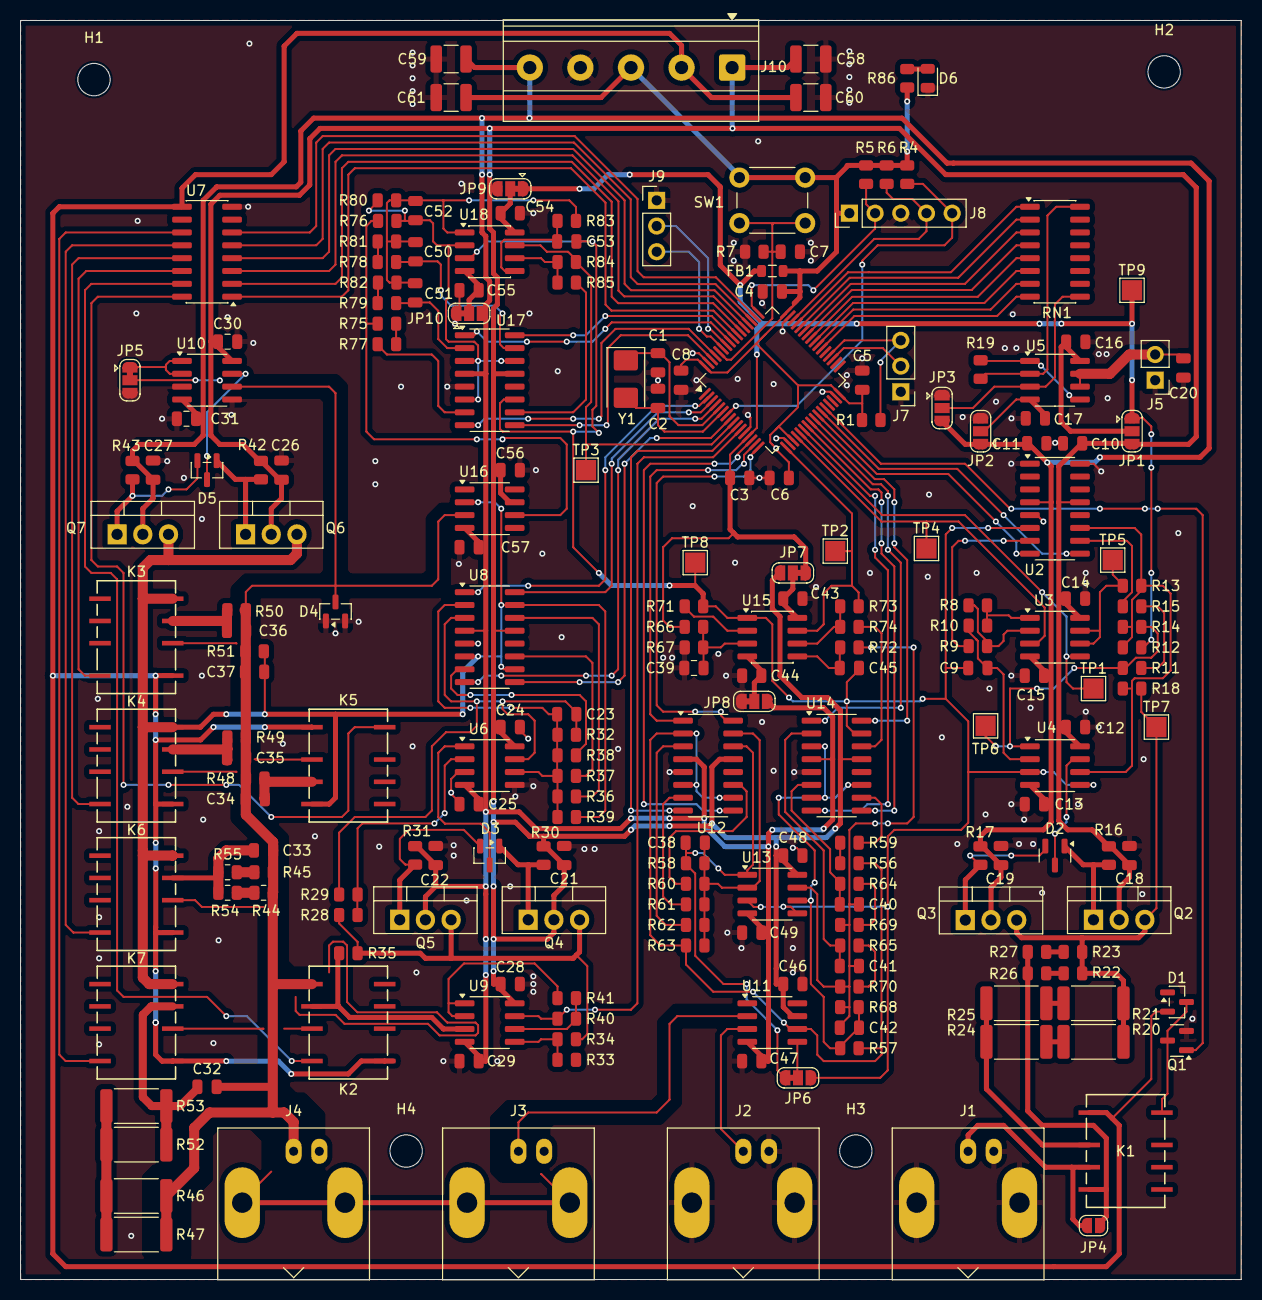
[picture p62: board Main Board.kicad_pcb from above]

Board: 2 copper layers, 120.7 x 124.5 mm, 219 parts (0 on the bottom side), 156 nets.
