DumberThanUsual/EEE3-Instrumentation/(commit log)

2026-01-15 InAmp First Draft
    [Amplifier.kicad_sch, Bridge.kicad_sch, Interface.kicad_sch, Main Board.kicad_pcb, Main Board.kicad_sch, Processor.kicad_sch, Protection.kicad_sch, Source.kicad_sch]
2026-01-15 InAmp Progress
    [Amplifier.kicad_sch, Bridge.kicad_sch, Interface.kicad_sch, Main Board.kicad_sch, Processor.kicad_sch, Protection.kicad_sch, Source.kicad_sch]
2026-01-16 ABB, InAmp
    [Amplifier.kicad_sch, Bridge.kicad_sch, Main Board.kicad_sch, Resistors.kicad_sch, Source.kicad_sch]
2026-01-16 Fix schematics location
2026-01-16 Bias sense resistors
    [Main Board.kicad_sch]
2026-01-20 Paniking further
    [Amplifier.kicad_sch, Bridge.kicad_sch, Main Board.kicad_sch, Power.kicad_sch, Processor.kicad_sch, Resistors.kicad_sch]
2026-01-22 parts selection
    [Amplifier.kicad_sch, Bridge.kicad_sch, Resistors.kicad_sch, Source.kicad_sch]
2026-01-24 minor: pwr, stm, filters
    [Amplifier.kicad_sch, Main Board.kicad_sch, Power.kicad_sch, Processor.kicad_sch, Source.kicad_sch]
2026-01-25 Update Main Board.pdf
2026-02-24 code :(
    [Processor.kicad_sch]
2026-02-25 power supply
    [Bridge.kicad_sch, Power.kicad_sch, Processor.kicad_sch, Resistors.kicad_sch, Source.kicad_sch]
2026-02-25 buffers designed
    [Bridge.kicad_sch, Main Board.kicad_sch]
2026-02-26 Amplifier Switch
    [Amplifier.kicad_sch, Bridge.kicad_sch, Power.kicad_sch, Source.kicad_sch]
2026-02-26 created buffer subcircuit
    [Source.kicad_sch, buffer.kicad_sch]
2026-02-26 quality of life changes plus wiring plus buffering plus value changes
    [Amplifier.kicad_sch, Bridge.kicad_sch, Main Board.kicad_sch, Power.kicad_sch, Source.kicad_sch, buffer.kicad_sch]
2026-02-26 footprints and minor
    [Amplifier.kicad_sch, Bridge.kicad_sch, Main Board.kicad_pcb, Main Board.kicad_sch, Power.kicad_sch, Processor.kicad_sch, Resistors.kicad_sch, Source.kicad_sch]
2026-02-26 footprints and stm wiring
    [Bridge.kicad_sch, Main Board.kicad_sch, Power.kicad_sch, Processor.kicad_sch, Source.kicad_sch, currentamp.kicad_sch, voltageamp.kicad_sch]
2026-02-26 relays and layout begin
    [Bridge.kicad_sch, Main Board.kicad_pcb, Main Board.kicad_sch, Power.kicad_sch, Processor.kicad_sch, Resistors.kicad_sch, Source.kicad_sch, currentamp.kicad_sch]
2026-02-26 minor and layout
    [Bridge.kicad_sch, Main Board.kicad_pcb, Main Board.kicad_sch, Power.kicad_sch, Processor.kicad_sch, Resistors.kicad_sch, Source.kicad_sch, currentamp.kicad_sch]
2026-02-27 amplifer floorplan and relay footprint + minor
    [Bridge.kicad_sch, Main Board.kicad_pcb, Processor.kicad_sch, Resistors.kicad_sch, Source.kicad_sch, currentamp.kicad_sch, voltageamp.kicad_sch]
2026-02-27 minor and bugfix
    [Bridge.kicad_sch, Main Board.kicad_pcb, Source.kicad_sch]
2026-02-27 Revert "minor and bugfix"
    This reverts commit 370c3ce365efa92c60832cb4f717ef8263004ca2.
    [Bridge.kicad_sch, Main Board.kicad_pcb, Source.kicad_sch]
2026-02-27 Layout progress
    [Bridge.kicad_sch, Main Board.kicad_pcb, Main Board.kicad_sch, Processor.kicad_sch, voltageamp.kicad_sch]
2026-02-27 transistor tester
    [Bridge.kicad_sch, Main Board.kicad_sch, dac.kicad_sch, voltageamp.kicad_sch]
2026-02-27 beep beep
    [Bridge.kicad_sch, Main Board.kicad_pcb, Source.kicad_sch, currentamp.kicad_sch, dac.kicad_sch]
2026-02-28 changed to multiple feedback and minor error correction
    [Bridge.kicad_sch, Source.kicad_sch, currentamp.kicad_sch, dac.kicad_sch, voltageamp.kicad_sch]
2026-02-28 minor schematic changes
    [Bridge.kicad_sch, Main Board.kicad_sch, Processor.kicad_sch, dac.kicad_sch]
2026-02-28 sorry i fell asleep b4 layout
    [Bridge.kicad_sch, Main Board.kicad_pcb, Main Board.kicad_sch, Power.kicad_sch, Processor.kicad_sch, Resistors.kicad_sch, Source.kicad_sch, currentamp.kicad_sch]
2026-03-01 fb capacitances for abb
    [Resistors.kicad_sch]
2026-03-01 resistor footprints changed
    [4816P-R2R-103LF.stp, Bridge.kicad_sch, EDI2CAP.CFG, Main Board.kicad_pcb, Resistors.kicad_sch, Source.kicad_sch, chips.prt]
2026-03-01 co-op test
    [Main Board.kicad_pcb]
2026-03-01 move resistors
    [Main Board.kicad_pcb]
2026-03-01 sig source layout prelim
    [Main Board.kicad_pcb]
2026-03-01 relay driver sims
2026-03-01 sig source finished
    [Bridge.kicad_sch, Main Board.kicad_pcb, Main Board.kicad_sch, Power.kicad_sch, Processor.kicad_sch, Resistors.kicad_sch, Source.kicad_sch, currentamp.kicad_sch]
2026-03-01 Krill me
    [Bridge.kicad_sch, Main Board.kicad_pcb]
2026-03-01 please be nice
    [Bridge.kicad_sch, Main Board.kicad_pcb, Main Board.kicad_sch, Power.kicad_sch, Processor.kicad_sch, Resistors.kicad_sch, Source.kicad_sch, currentamp.kicad_sch]
2026-03-01 sufferage 2
    [Main Board.kicad_pcb, Processor.kicad_sch, Source.kicad_sch]
2026-03-02 Final Schematic
    [Bridge.kicad_sch, Main Board.kicad_pcb, Main Board.kicad_sch, Power.kicad_sch, Processor.kicad_sch, Resistors.kicad_sch, Source.kicad_sch, currentamp.kicad_sch]
2026-03-02 change footprints
    [Main Board.kicad_sch]
2026-03-02 zipped gerbers
2026-03-02 minor cleanup from the party
    [Bridge.kicad_sch, Main Board.kicad_pcb, Main Board.kicad_sch, Power.kicad_sch, Processor.kicad_sch, Resistors.kicad_sch, Source.kicad_sch, currentamp.kicad_sch]
2026-03-03 footprints and tps
    [Main Board.kicad_sch, Power.kicad_sch, Processor.kicad_sch, Source.kicad_sch, voltageamp.kicad_sch]
2026-03-05 ready to krill myself
    [Main Board.kicad_pcb, Processor.kicad_sch]
2026-03-05 whats even the point anymore
    [Main Board.kicad_pcb]
2026-03-05 final hopefully
    [Main Board.kicad_pcb]
2026-03-22 ujpdated code
    [Processor.kicad_sch, voltageamp.kicad_sch]
2026-03-24 final sims ❌
